xx979xx/neo/giraffe/fca/README.md

FCA (Fiat Chrysler Automotive) Giraffe
====

Get your panda deeper into your:

- 2017 Chrysler Pacifica Hybrid

May fit other FCA cars as well.

The switches
====

The 2 DIP switches control signals to the stock ADAS system

- 1 -- IGN to camera

- 2 -- ADAS CAN1 -> camera CAN (OBDII pins 12 & 13)

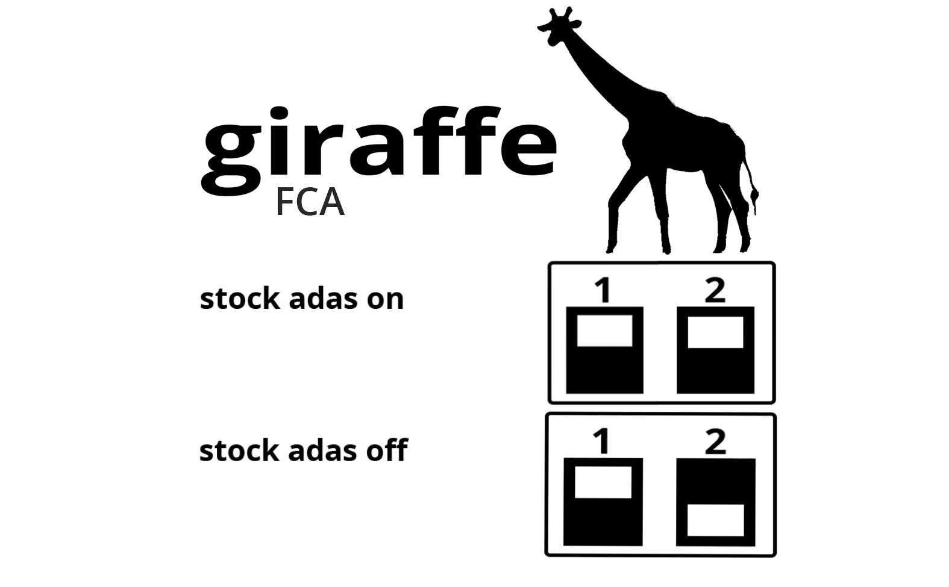
[picture p1: giraffe/fca/fca_switches.png]


Initial design from the community from: [@adhintz](https://github.com/adhintz)
