xx979xx/neo/giraffe/toyota/README.md

Toyota giraffe
====

Get your panda deeper into your compatible Toyota vehicle

The switches
====

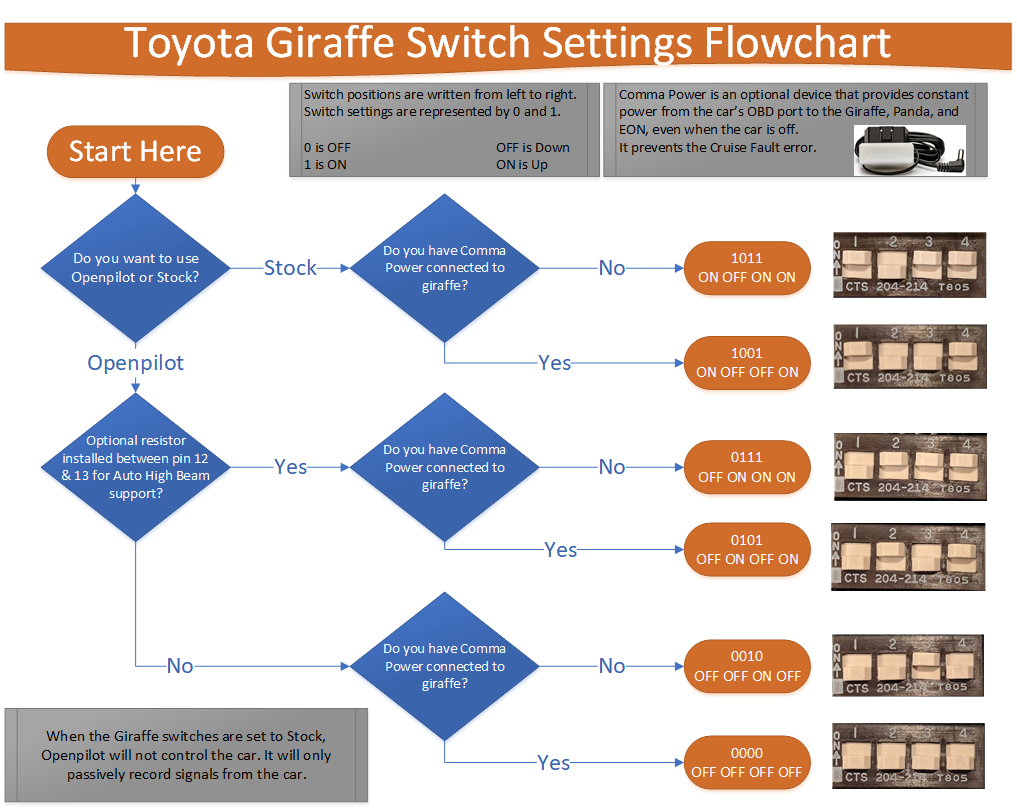
[picture p2: giraffe/toyota/toyota_giraffe_switch_flowchart.png]
