xx979xx/neo/giraffe/honda/bosch/README.md

Honda giraffe (Bosch ADAS)
====

Get your panda deeper into your:

- 2017+ Honda CR-V
- 2017+ Honda Civic Hatchback
- 2018+ Honda Accord

May fit other Hondas with Bosch hardware as well.

The switches
====

The 2 DIP switches control signals to the stock ADAS system

- 1 -- IGN to camera

- 2 -- ADAS CAN2 -> camera CAN (OBDII pins 12 & 13)

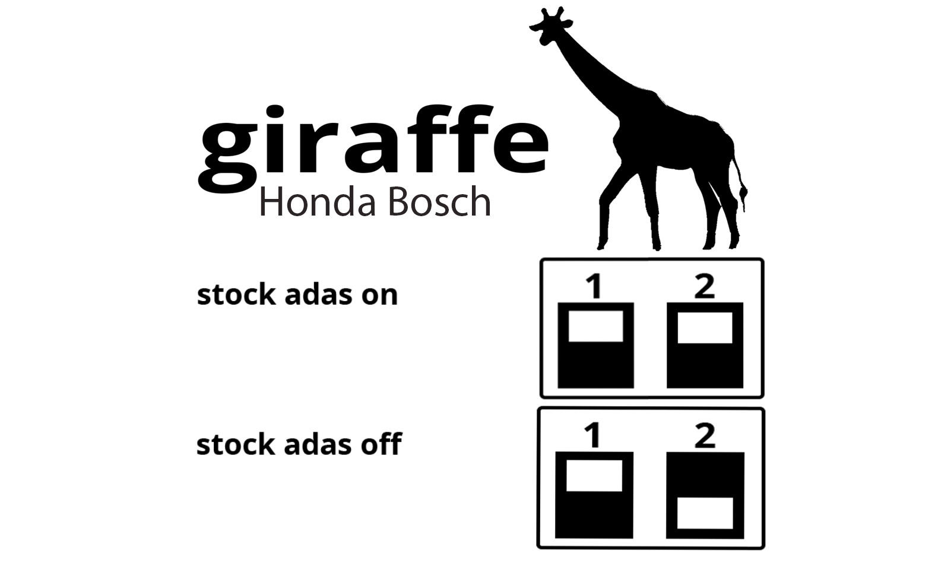
[picture p3: giraffe/honda/bosch/bosch_switches.png]


Initial design from the community from: [@csouers](https://github.com/csouers), [@energee](https://github.com/energee), and Alaric Egli
