xx979xx/neo/giraffe/honda/nidec_inverted/README.md

Honda Inverted Giraffe
====

Get your panda deeper into your Odyssey, 2019 Honda Pilot, TLX and probably other cars with an "inverted" connector

The switches
====

The 4 DIP switches control signals to the stock ADAS system

- 1 -- ADAS CAN1 -> main body CAN

- 2 -- ADAS CAN1 -> panda CAN3 (OBDII pins 12 & 13)

- 3 -- ADAS CAN2 -> radar CAN

- 4 -- ADAS power & ignition -> power & ignition

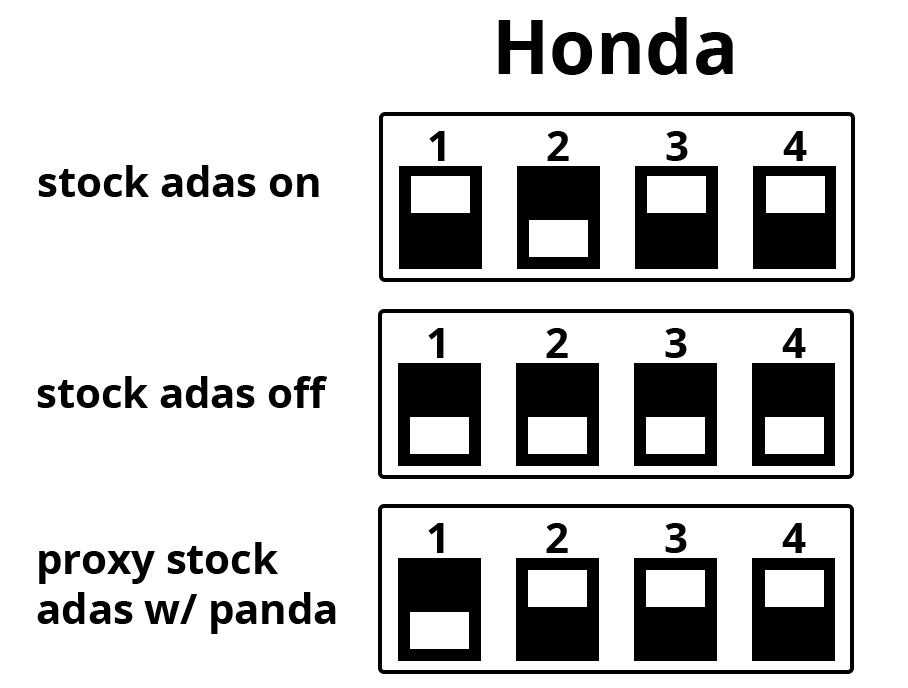
[picture p4: giraffe/honda/nidec_inverted/nidec_switches.png]


Thanks to [@csouers](https://github.com/csouers) and [@energee](https://github.com/energee) for their input on this design
