xx979xx/neo/interface boards/gm/resources/1) front.jpg

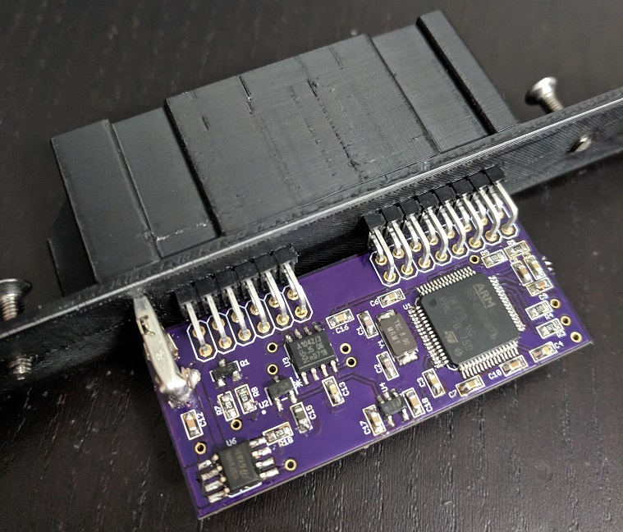
interface boards/gm/resources/1) front.jpg
