xx979xx/neo/interface boards/gm/resources/2) power pins.jpg

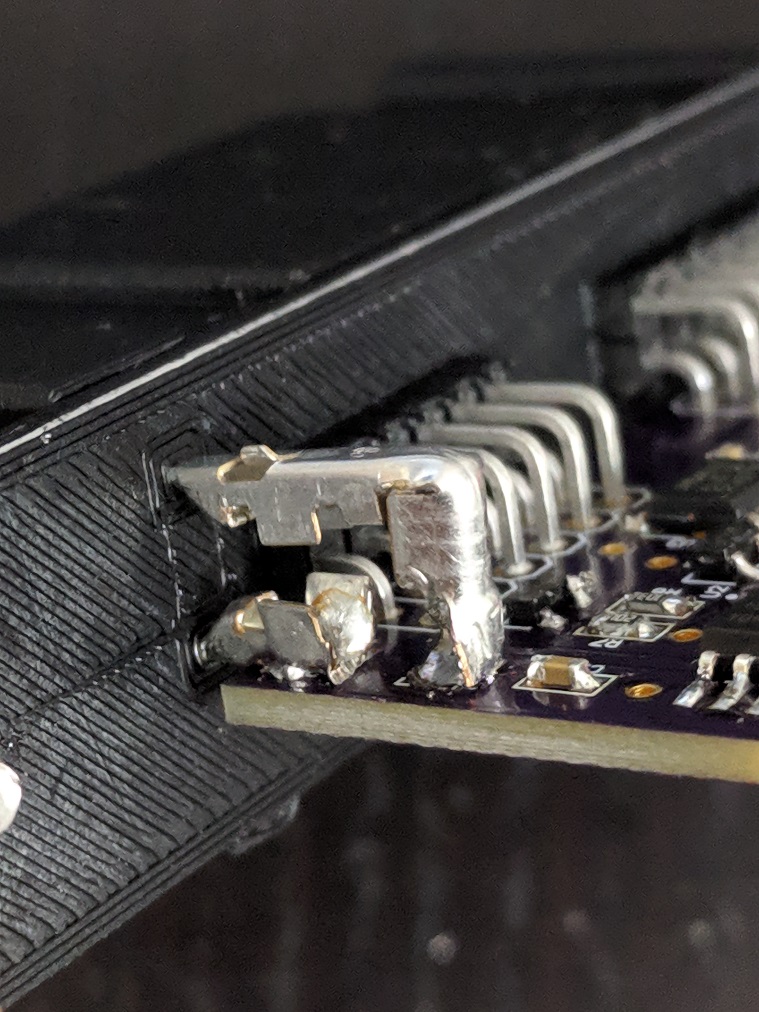
interface boards/gm/resources/2) power pins.jpg
