xx979xx/neo/interface boards/gm/resources/3) back.jpg

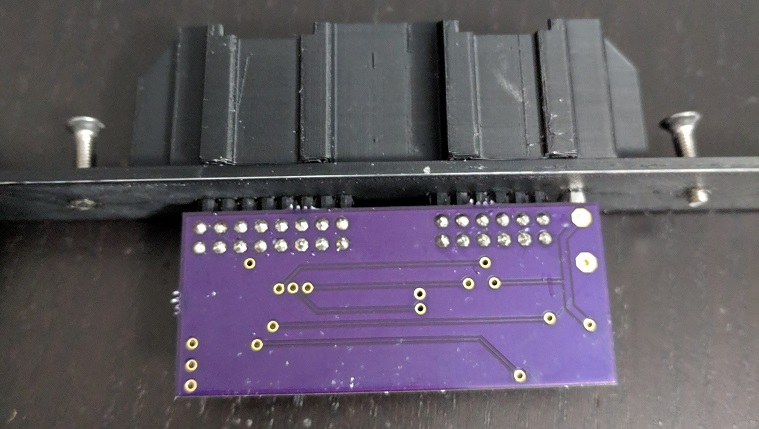
interface boards/gm/resources/3) back.jpg
