xx979xx/neo/interface boards/gm/resources/4) pin immobilizer.jpg

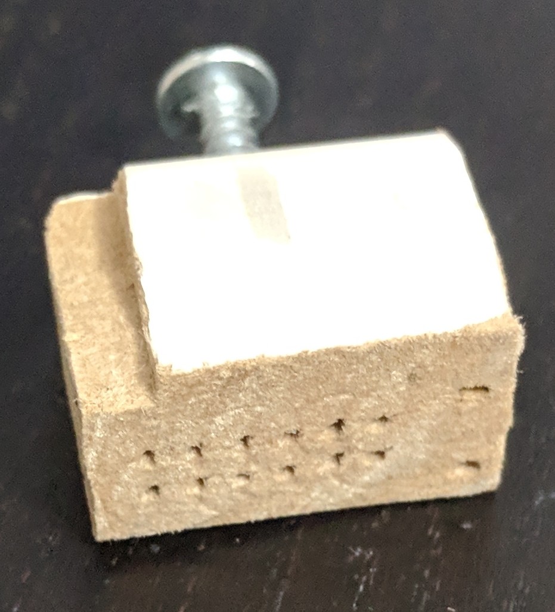
interface boards/gm/resources/4) pin immobilizer.jpg
