xx979xx/neo/giraffe/hyundai/BOM.csv

Ref Des | Package | Manufacturer PN | Qty | Link
U1 | 12-Pin | MG645845 | 1 | https://chcwld.en.alibaba.com/product/60784996669-801836231/KET_020_12M_Automotive_cable_connector_Electronic_Connector.html
U2 | 12-Pin | MG655794 | 1 | https://chcwld.en.alibaba.com/product/60784830234-801836231/KET_020_12F_Automotive_cable_connector_Electronic_Connector.html
 |  | ST731407-3 | 12
J1 | 16-pin | OBDII-FEMALE | 1 | https://cn1514770021qfbj.en.alibaba.com/product/60598699808-804284542/J1962F_OBD2_16_Pin_Female_connector_OBD2_Socket.html
J2 | RJ45-RA | A-2004-2-4-LPS-N-R | 1 | https://www.digikey.com/product-detail/en/assmann-wsw-components/A-2004-2-4-LPS-N-R/AE10387-ND/2183638
J3 | 3-pin | EJ508A | 1 | https://www.digikey.com/products/en?keywords=ej508a
SW1 | SMD | 204-214ST | 1 | https://www.digikey.com/scripts/DkSearch/dksus.dll?Detail&itemSeq=238874105&uq=636415194298612120
R1 | 0603-R | ERJ-PA3J121V | 1 | https://www.digikey.com/product-detail/en/panasonic-electronic-components/ERJ-PA3J121V/P120BZCT-ND/5036246
