xx979xx/neo/giraffe/fca/Giraffe_left.stl

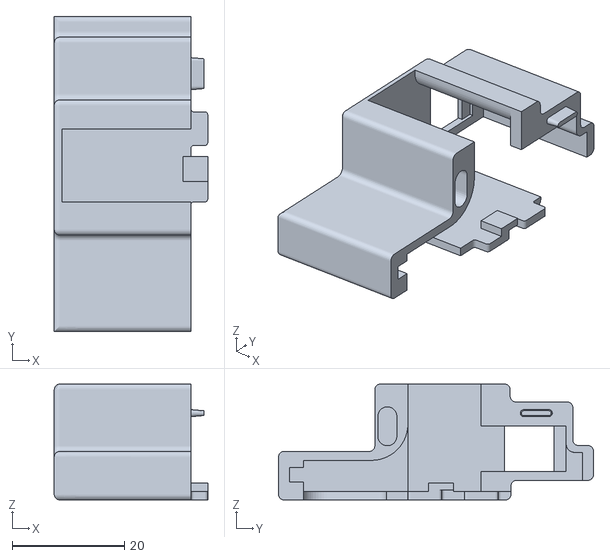
[picture p9: CAD file, 2019-06-29]
giraffe/fca/Giraffe_left.stl
27.4 x 56.2 x 20.7
