xx979xx/neo/giraffe/ford/mechanical/giraffe_ford_spacer.stl

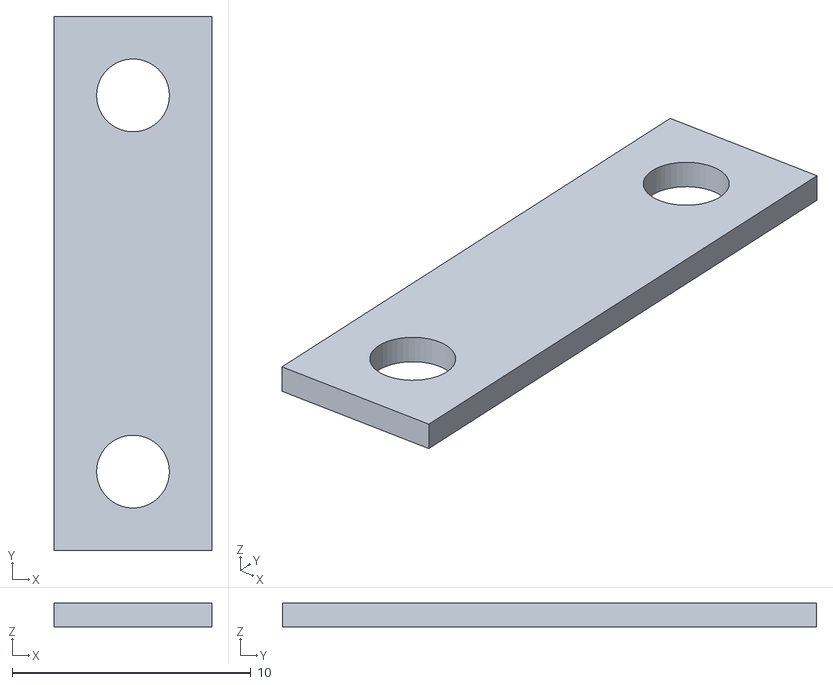
[picture p10: CAD file, 2019-06-29]
giraffe/ford/mechanical/giraffe_ford_spacer.stl
6.60 x 22.4 x 1.00
