xx979xx/neo/giraffe/honda/bosch/bosch_female_connector.stl

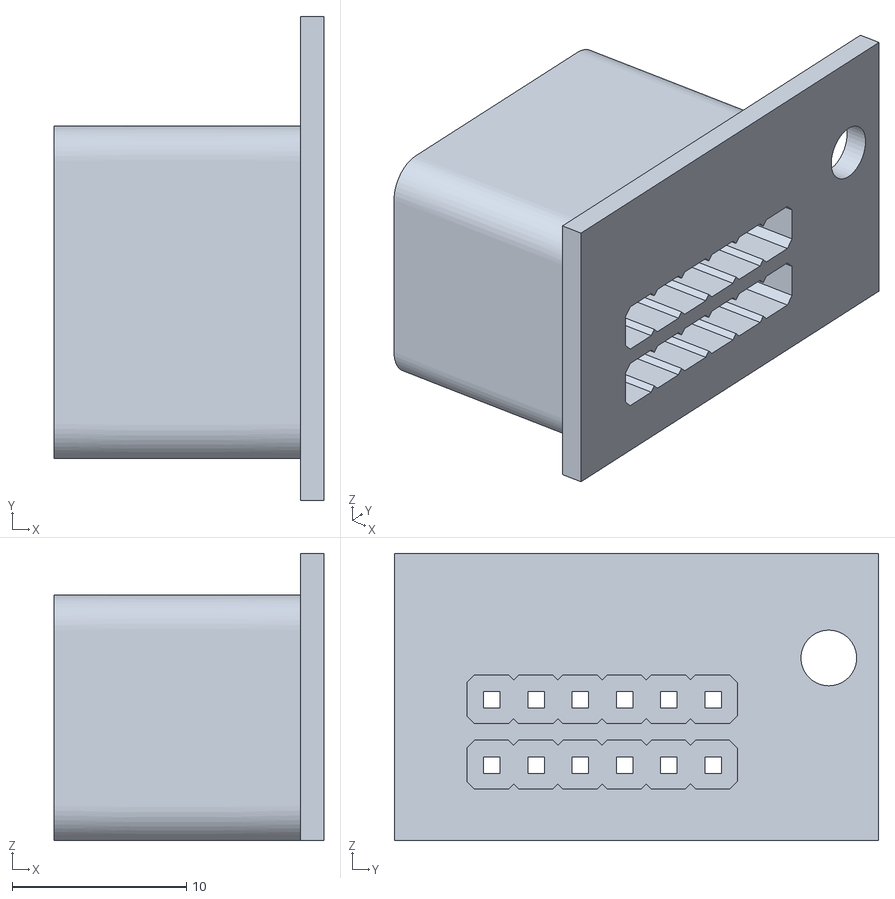
[picture p11: CAD file, 2019-06-29]
giraffe/honda/bosch/bosch_female_connector.stl
15.5 x 27.8 x 16.5
