xx979xx/neo/giraffe/honda/nidec_inverted/case.stl

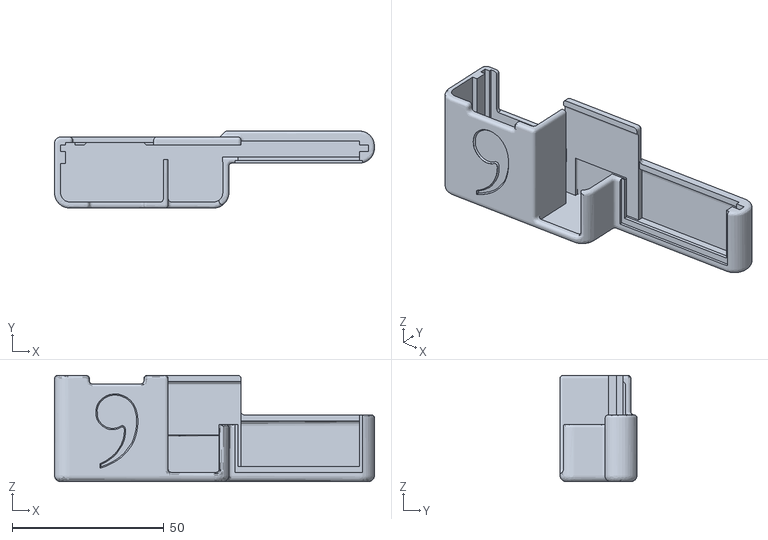
[picture p12: CAD file, 2019-06-29]
giraffe/honda/nidec_inverted/case.stl
105.5 x 25.4 x 35.0
