xx979xx/neo/giraffe/hyundai/Hyundai_Giraffe.stl

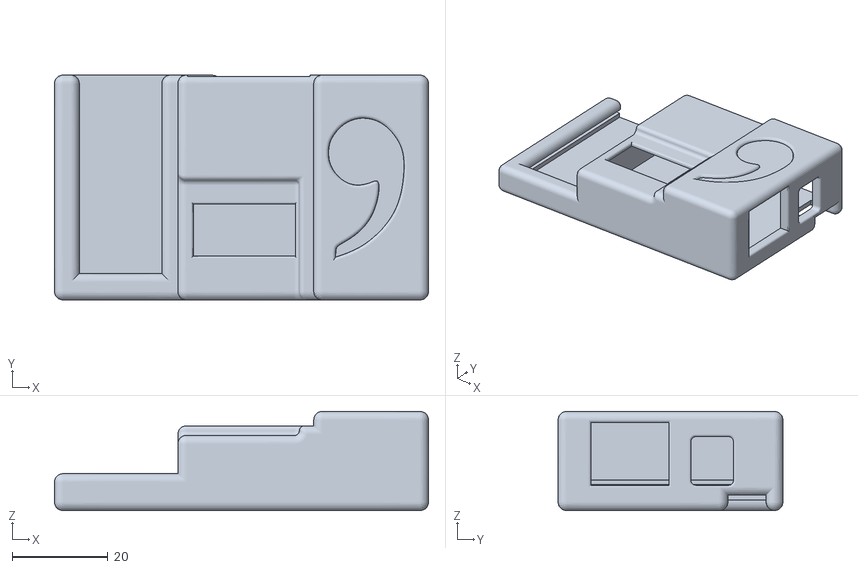
[picture p13: CAD file, 2019-06-29]
giraffe/hyundai/Hyundai_Giraffe.stl
78.2 x 47.0 x 20.7
