xx979xx/neo/giraffe/subaru/PIP_right.stl

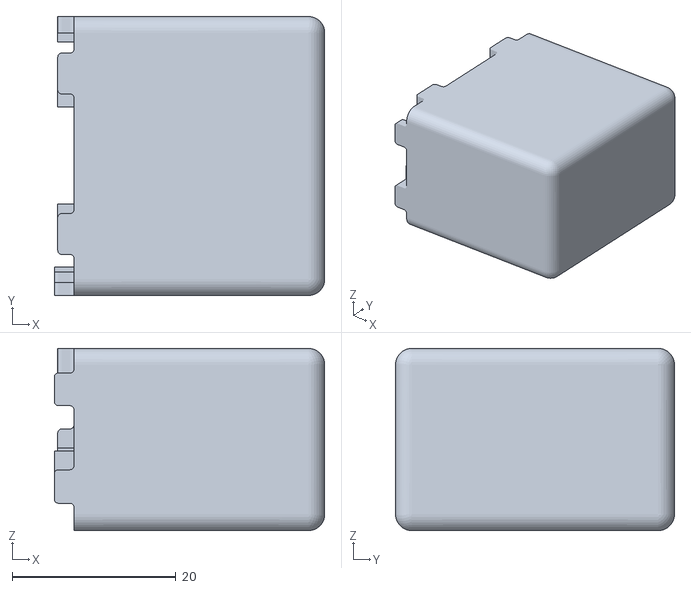
[picture p14: CAD file, 2019-06-29]
giraffe/subaru/PIP_right.stl
33.1 x 34.1 x 22.3
