xx979xx/neo/grey/antenna_mount_28deg.stl

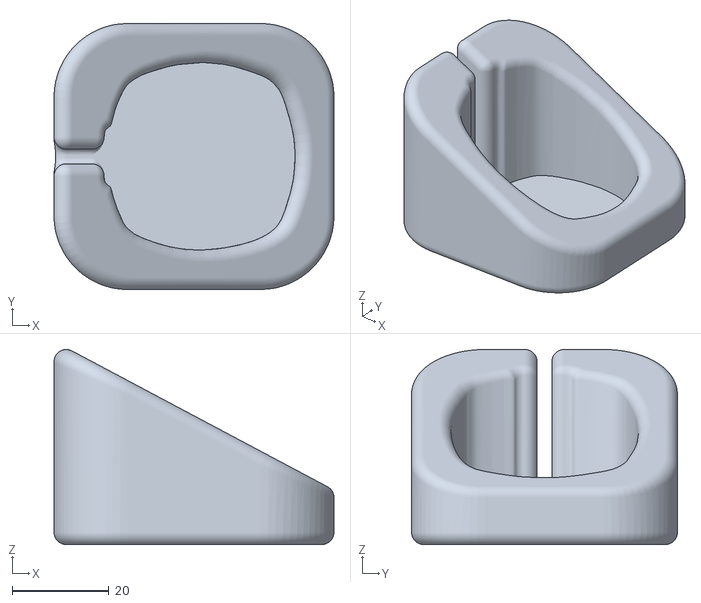
[picture p15: CAD file, 2019-06-29]
grey/antenna_mount_28deg.stl
58.0 x 55.1 x 40.4
