xx979xx/neo/interface boards/gm/case.stl

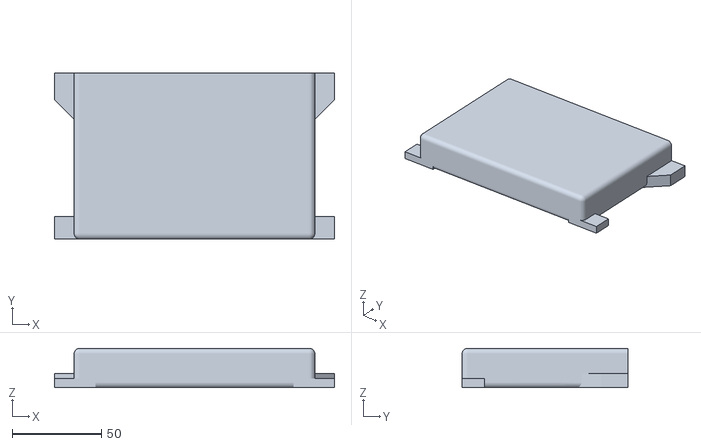
[picture p16: CAD file, 2019-06-29]
interface boards/gm/case.stl
157.0 x 93.0 x 22.0
