xx979xx/neo/giraffe/fca/Giraffe_right.stl

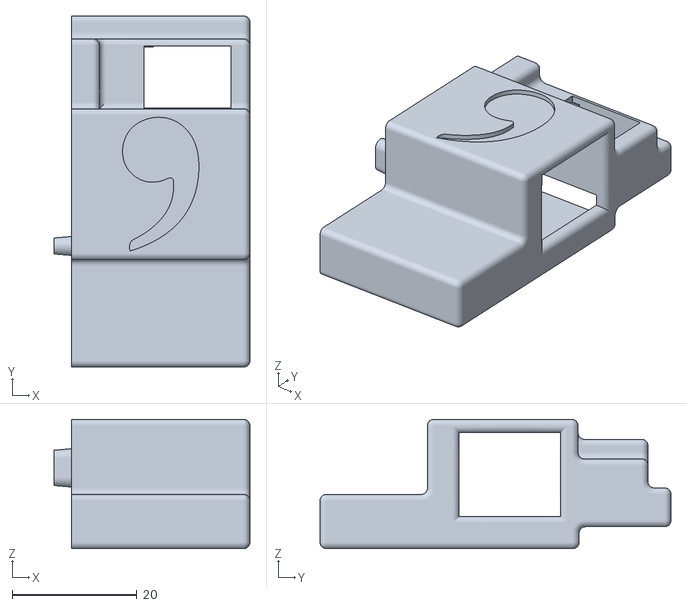
[picture p17: CAD file, 2019-06-29]
giraffe/fca/Giraffe_right.stl
31.4 x 56.2 x 20.7
