xx979xx/neo/giraffe/ford/mechanical/giraffe_ford_top.stl

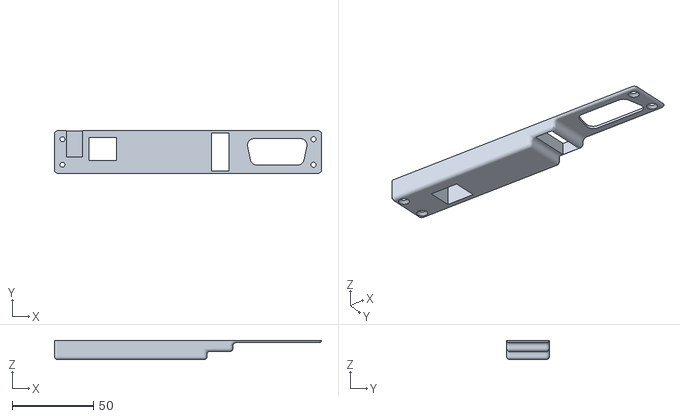
[picture p18: CAD file, 2019-06-29]
giraffe/ford/mechanical/giraffe_ford_top.stl
164.5 x 26.4 x 11.9
