xx979xx/neo/giraffe/honda/bosch/bosch_male.stl

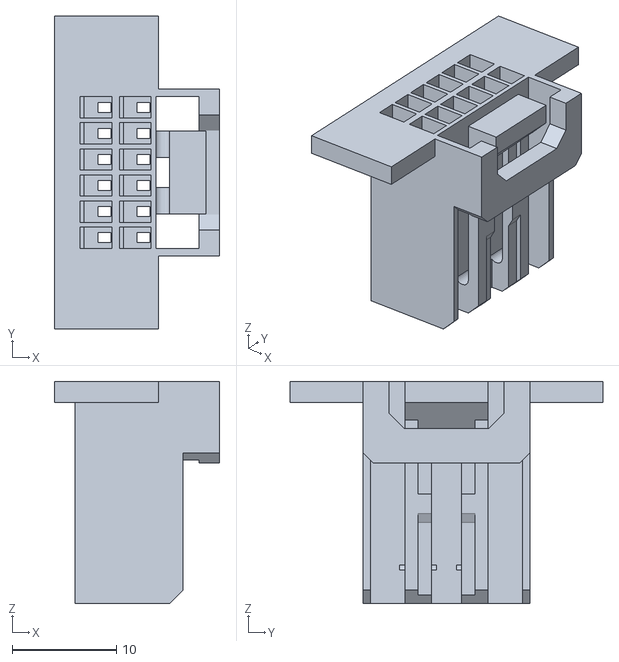
[picture p19: CAD file, 2019-06-29]
giraffe/honda/bosch/bosch_male.stl
15.9 x 30.0 x 21.3
