xx979xx/neo/giraffe/subaru/PIP_left.stl

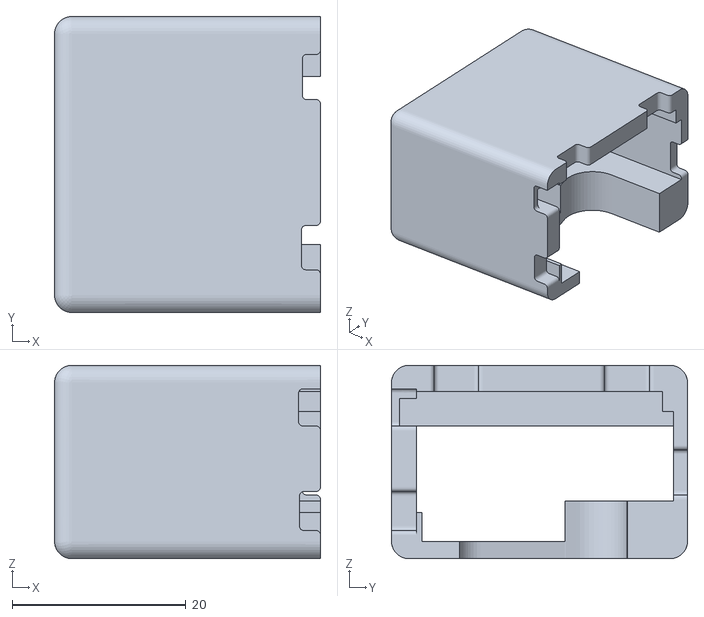
[picture p20: CAD file, 2019-06-29]
giraffe/subaru/PIP_left.stl
30.6 x 34.1 x 22.3
