xx979xx/neo/interface boards/gm/connectors.stl

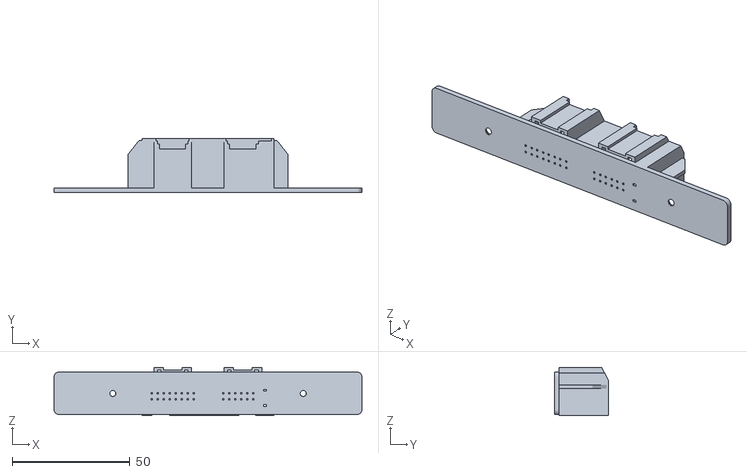
[picture p21: CAD file, 2019-06-29]
interface boards/gm/connectors.stl
131.0 x 23.0 x 20.5
