xx979xx/neo/giraffe/ford/mechanical/giraffe_ford_bottom.stl

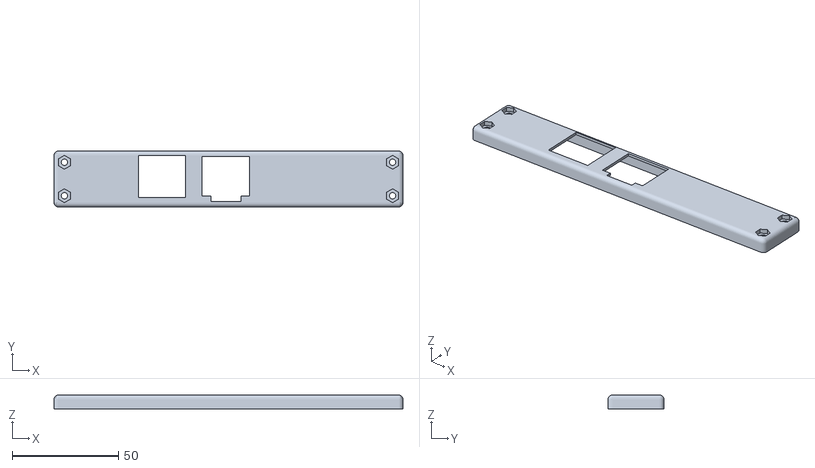
[picture p22: CAD file, 2019-06-29]
giraffe/ford/mechanical/giraffe_ford_bottom.stl
164.5 x 26.4 x 6.57
