xx979xx/neo/giraffe/honda/bosch/bosch_back.stl

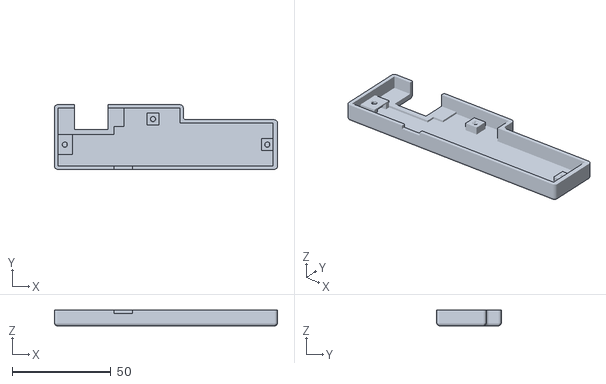
[picture p23: CAD file, 2019-06-29]
giraffe/honda/bosch/bosch_back.stl
113.0 x 32.7 x 8.00
