xx979xx/neo/giraffe/honda/bosch/bosch_front.stl

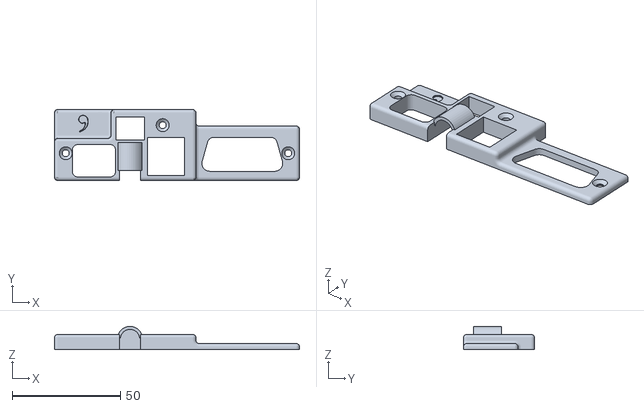
[picture p24: CAD file, 2019-06-29]
giraffe/honda/bosch/bosch_front.stl
113.0 x 32.7 x 10.7
