xx979xx/neo/paw/paw.brd

## EAGLE design paw/paw.brd (2019-06-29)

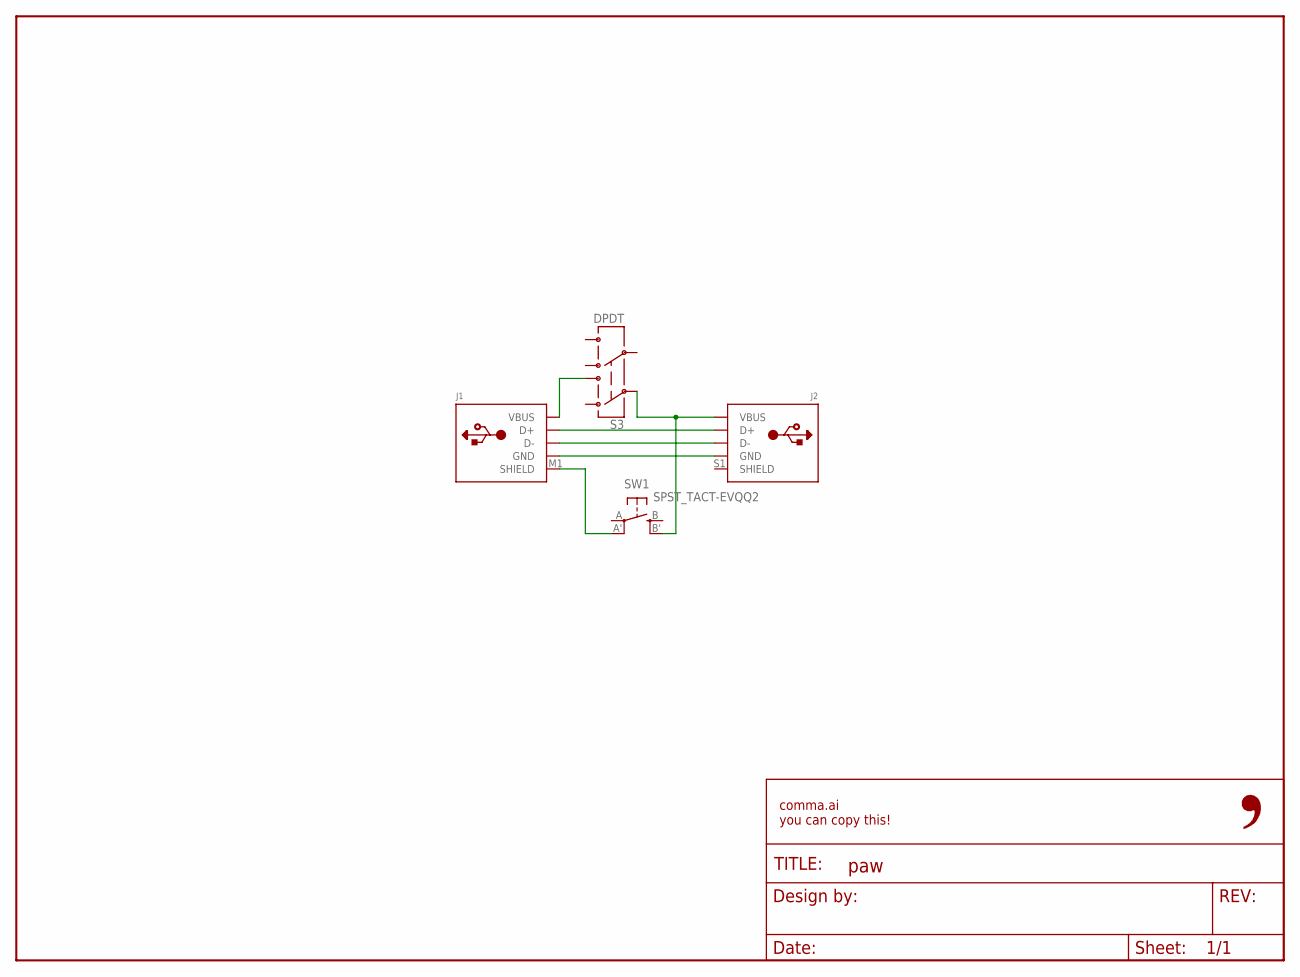
[picture p25: schematic paw.sch]

Parts:
FRAME1: FRAME-LETTER-OPENNO_PACKAGE; DUMMY
J1: USB-AA-M; MOLEX_480371000
J2: USB-MINIBSMD; USB-MINIB
S3: DPDT; AYZ0202
SW1: SPST_TACT-EVQQ2; EVQ-Q2

Connections:
unnamed: J1.3 (D+), J2.D+
unnamed: J1.2 (D-), J2.D-
unnamed: J1.4 (GND), J2.GND
unnamed: J1.M1 (SHIELD), SW1.A' (P1)
unnamed: J1.1 (VBUS), S3.3
unnamed: J2.VBUS, S3.2, SW1.B' (S1)

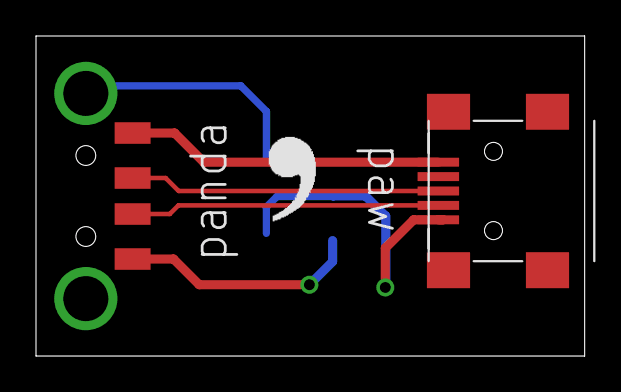
[picture p26: board paw.brd from above]

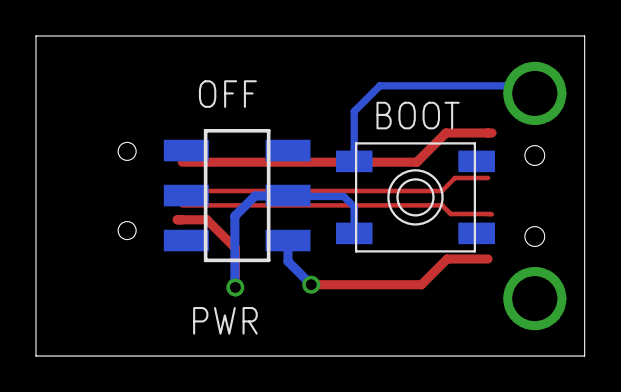
[picture p27: board paw.brd from below]

Board: 2 copper layers, 30.5 x 17.8 mm, 6 parts (2 on the bottom side), 6 nets.

Other parts of the board:
U$1: LOGO
