xx979xx/neo/giraffe/fca/fca_giraffe.brd

## EAGLE design giraffe/fca/fca_giraffe.brd (2019-06-29)

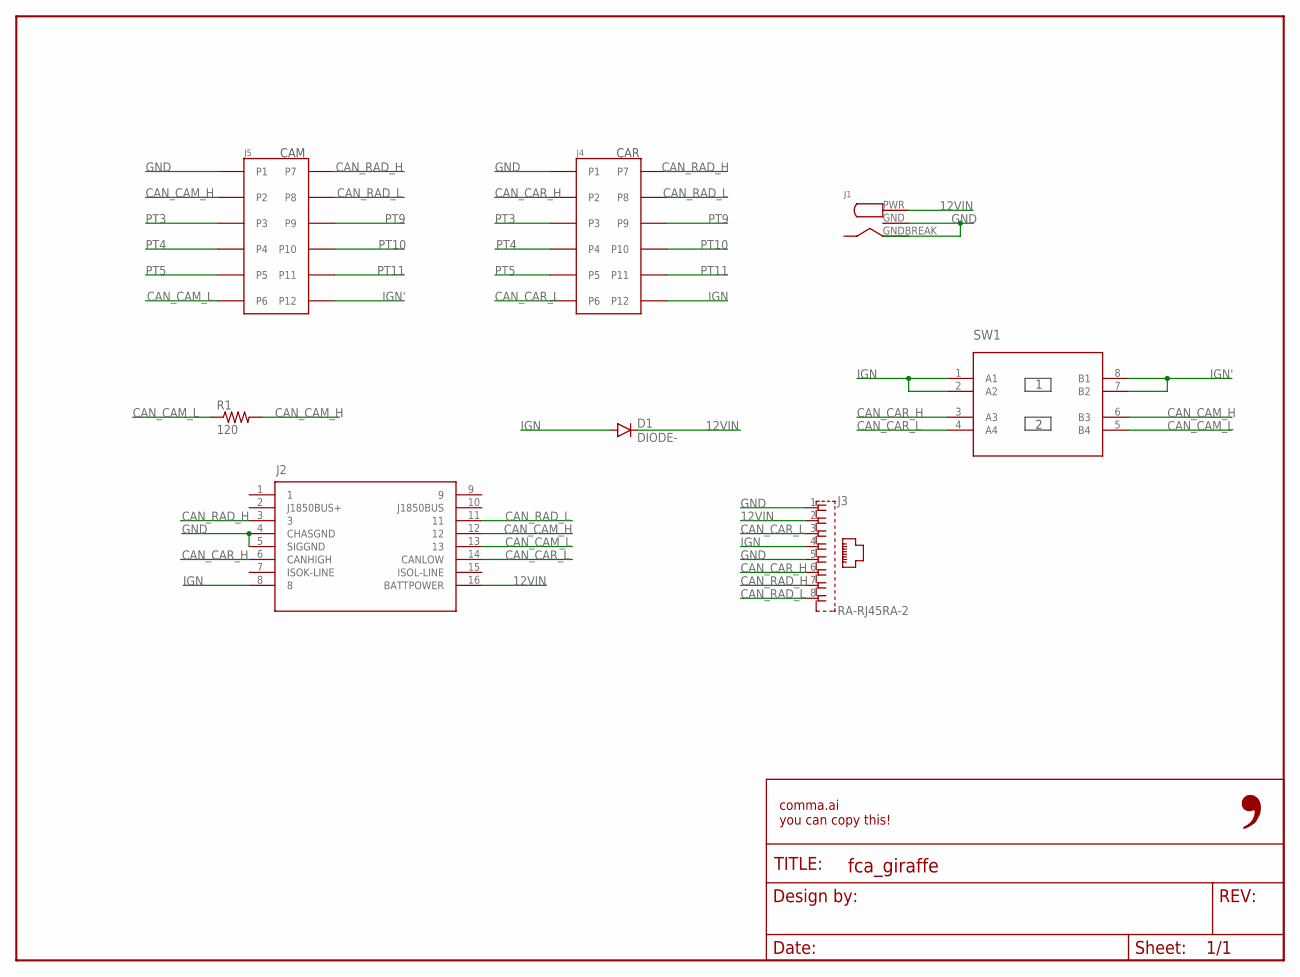
[picture p30: schematic fca_giraffe.sch]

Parts:
D1: DIODE-; DO-214
FRAME1: FRAME-LETTER-OPENNO_PACKAGE; DUMMY
J1: RASM722PX
J2: OBDII-FEMALE-CUT; OBDII-FEMALE-MIDCUT
J3: RA-RJ45RA-2; RA-RJ45-2
J4: 0348250124
J5: 0348240124
R1: 120; 0603-R
SW1: 2XDPST-CTS; 2-DPST

Connections:
12VIN: D1.1 (C), J1.PWR (12VIN), J2.16 (BATTPOWER), J3.2
CAN_CAM_H: J2.12, J5.P2, R1.2, SW1.6 (B3)
CAN_CAM_L: J2.13, J5.P6, R1.1, SW1.5 (B4)
CAN_CAR_H: J2.6 (CANHIGH), J3.6, J4.P2, SW1.3 (A3)
CAN_CAR_L: J2.14 (CANLOW), J3.3, J4.P6, SW1.4 (A4)
CAN_RAD_H: J2.3, J3.7, J4.P7, J5.P7
CAN_RAD_L: J2.11, J3.8, J4.P8, J5.P8
GND: J1.GND, J1.GNDBREAK, J2.4 (CHASGND), J2.5 (SIGGND), J3.1, J3.5, J4.P1, J5.P1
IGN: D1.2 (A), J2.8, J3.4, J4.P12, SW1.1 (A1), SW1.2 (A2)
IGN': J5.P12, SW1.7 (B2), SW1.8 (B1)
PT3: J4.P3, J5.P3
PT4: J4.P4, J5.P4
PT5: J4.P5, J5.P5
PT9: J4.P9, J5.P9
PT10: J4.P10, J5.P10
PT11: J4.P11, J5.P11

Notes on the sheet:
CAR
CAM

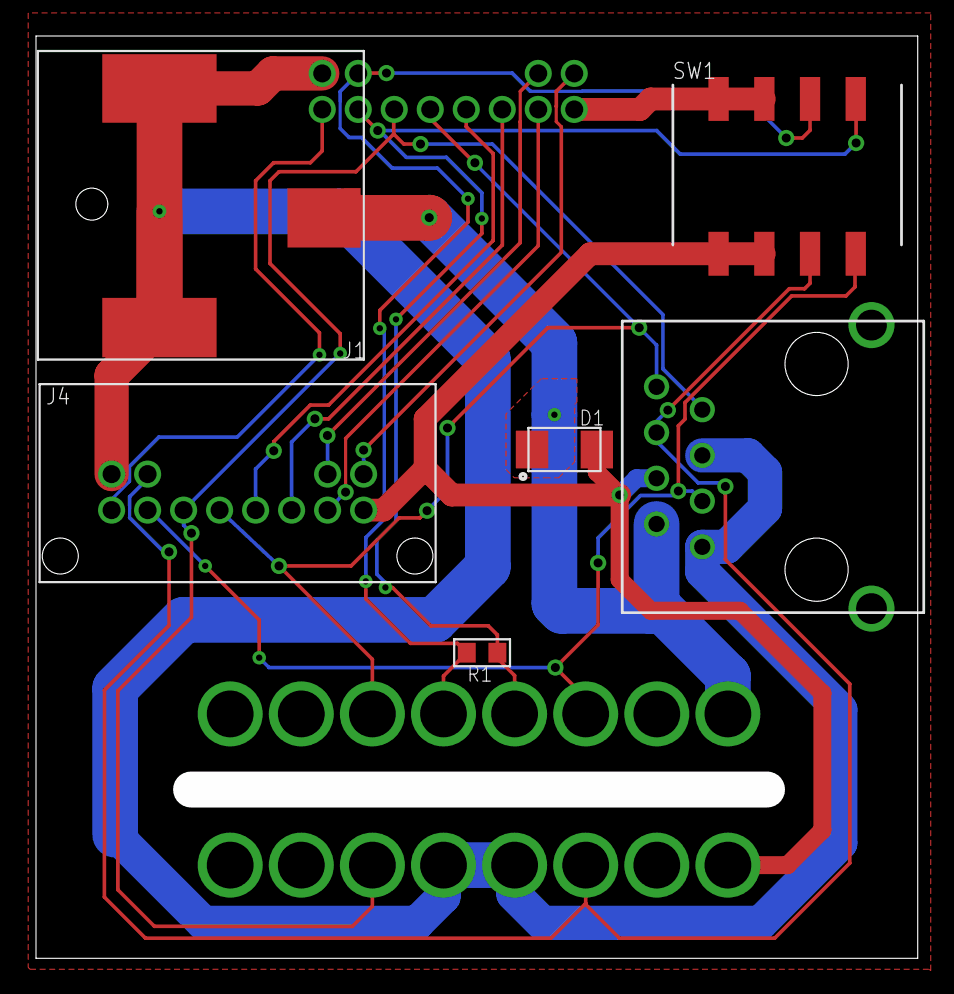
[picture p31: board fca_giraffe.brd from above]

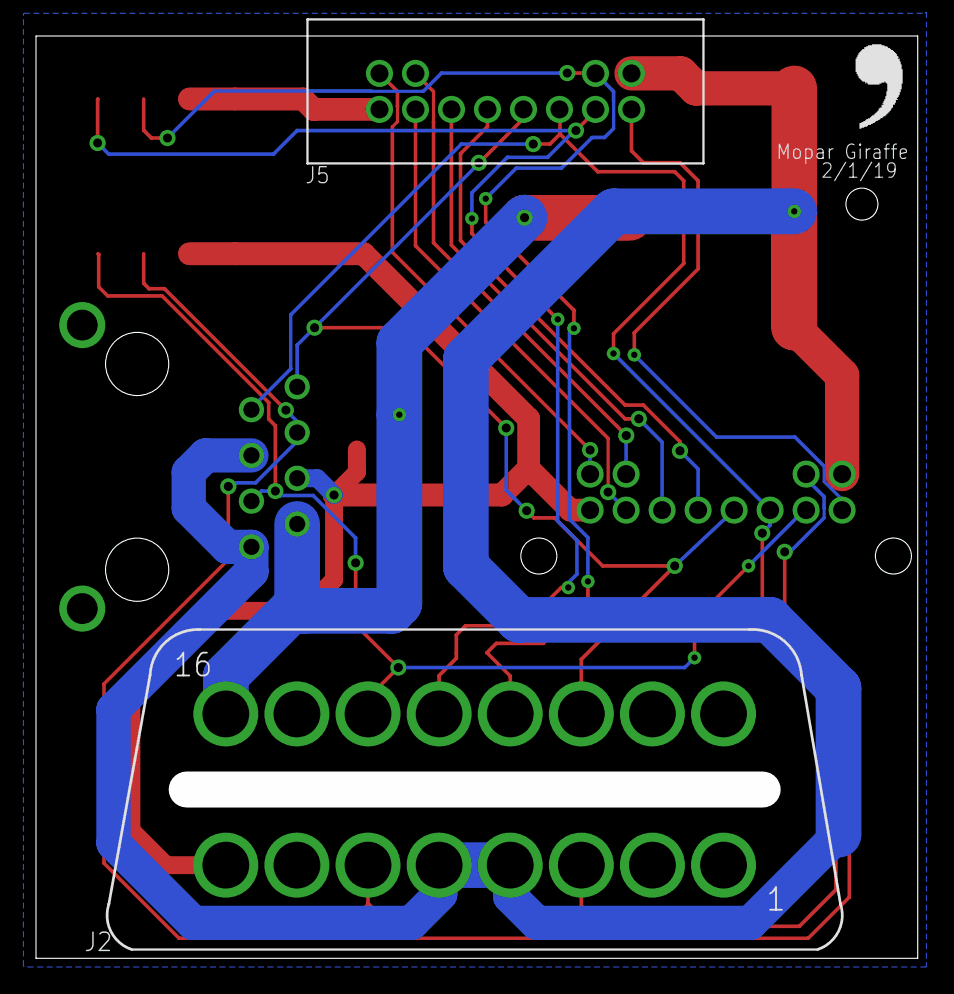
[picture p32: board fca_giraffe.brd from below]

Board: 2 copper layers, 49.0 x 51.2 mm, 10 parts (3 on the bottom side), 16 nets.

Other parts of the board:
U$1: LOGO
