xx979xx/neo/giraffe/toyota/giraffe12.brd

## EAGLE design giraffe/toyota/giraffe12.brd (2019-06-29)

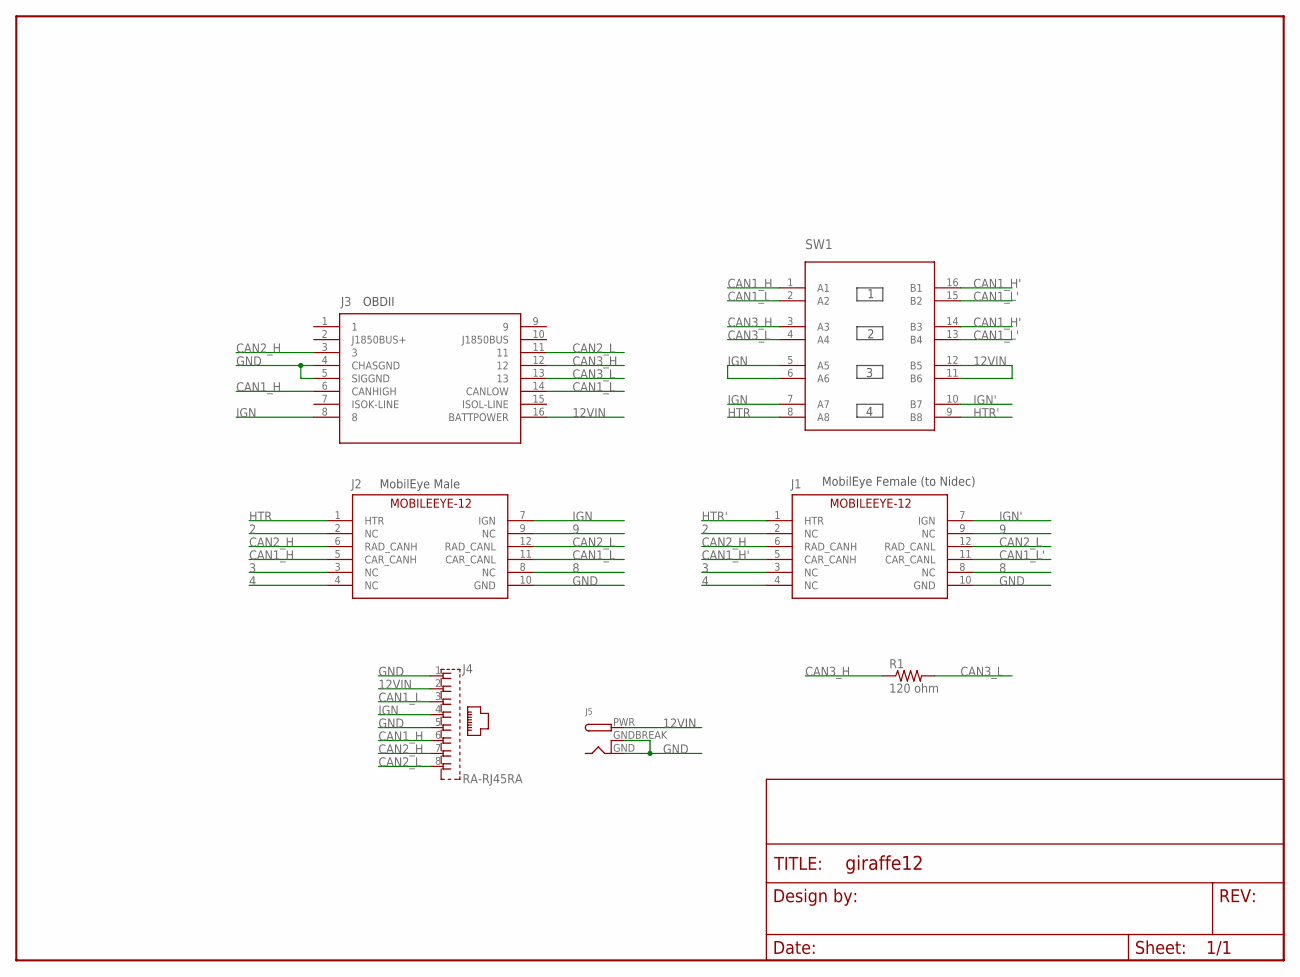
[picture p33: schematic giraffe12.sch]

Parts:
FRAME1: FRAME-LETTERNO_PACKAGE; DUMMY
J1: MOBILEEYE-12FEMALE; 2X6-TE-FEMALE
J2: MOBILEEYE-12MALE; 2X6-TE-RA
J3: OBDII-FEMALE-CUT; OBDII-FEMALE-MIDCUT
J4: RA-RJ45RA; RA-RJ45
J5: DCBARRELPTH; DCJACK_2MM_PTH
R1: 120 ohm; 0603-R
SW1: 4XDPSTSMT; 4-DPST

Connections:
2: J1.2 (NC), J2.2 (NC)
3: J1.3 (NC), J2.3 (NC)
4: J1.4 (NC), J2.4 (NC)
8: J1.8 (NC), J2.8 (NC)
9: J1.9 (NC), J2.9 (NC)
12VIN: J3.16 (BATTPOWER), J4.2, J5.PWR, SW1.11 (B6), SW1.12 (B5)
CAN1_H: J2.5 (CAR_CANH), J3.6 (CANHIGH), J4.6, SW1.1 (A1)
CAN1_H': J1.5 (CAR_CANH), SW1.14 (B3), SW1.16 (B1)
CAN1_L: J2.11 (CAR_CANL), J3.14 (CANLOW), J4.3, SW1.2 (A2)
CAN1_L': J1.11 (CAR_CANL), SW1.13 (B4), SW1.15 (B2)
CAN2_H: J1.6 (RAD_CANH), J2.6 (RAD_CANH), J3.3, J4.7
CAN2_L: J1.12 (RAD_CANL), J2.12 (RAD_CANL), J3.11, J4.8
CAN3_H: J3.12, R1.1, SW1.3 (A3)
CAN3_L: J3.13, R1.2, SW1.4 (A4)
GND: J1.10 (GND), J2.10 (GND), J3.4 (CHASGND), J3.5 (SIGGND), J4.1, J4.5, J5.GND, J5.GNDBREAK
HTR: J2.1 (HTR), SW1.8 (A8)
HTR': J1.1 (HTR), SW1.9 (B8)
IGN: J2.7 (IGN), J3.8, J4.4, SW1.5 (A5), SW1.6 (A6), SW1.7 (A7)
IGN': J1.7 (IGN), SW1.10 (B7)

Notes on the sheet:
OBDII
MobilEye Male
MobilEye Female (to Nidec)

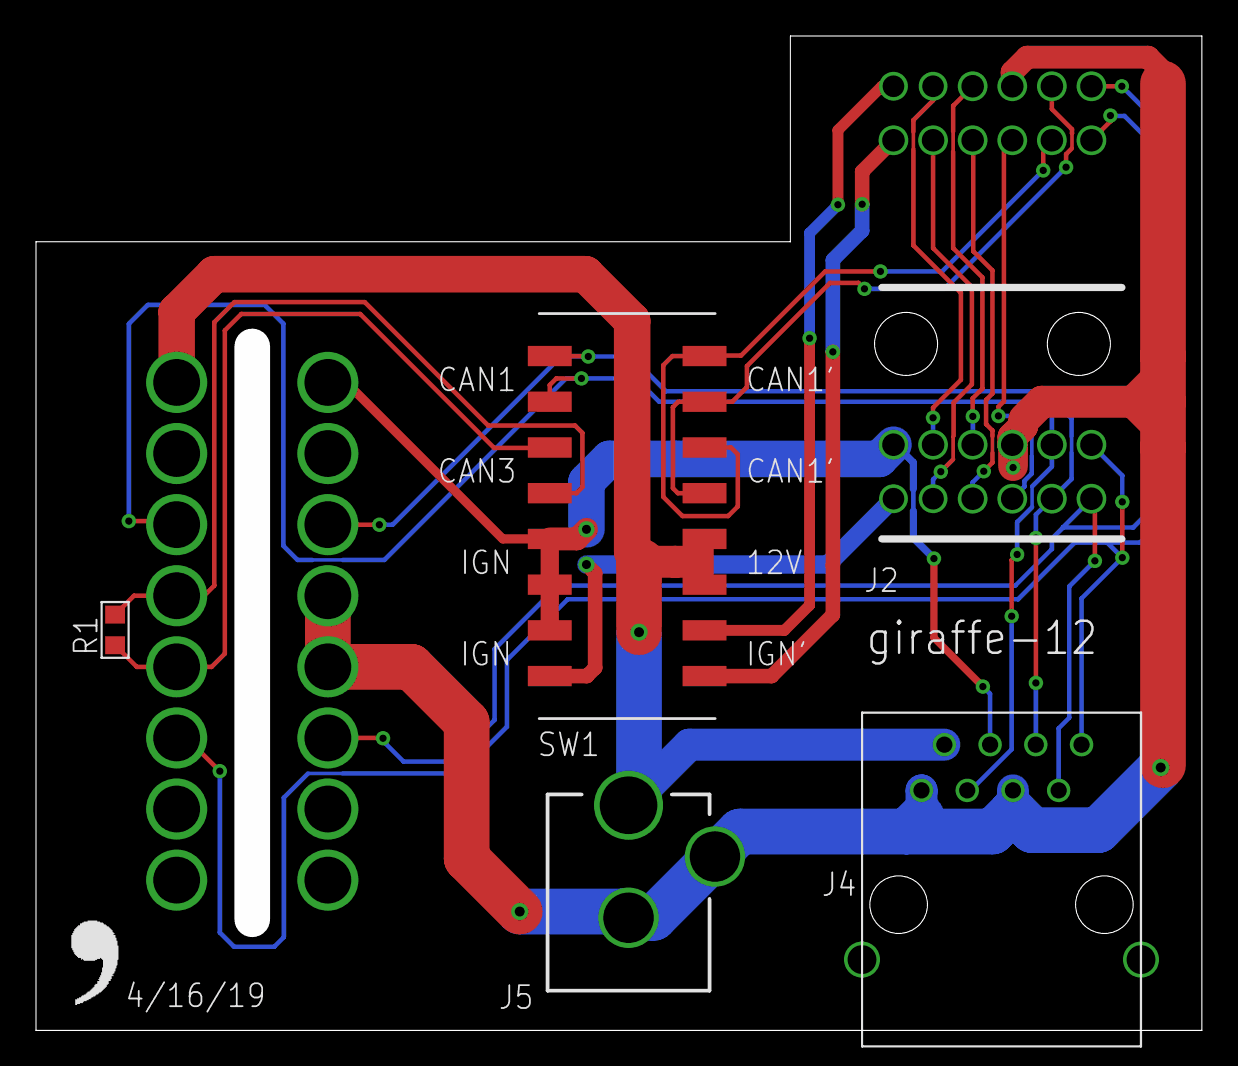
[picture p34: board giraffe12.brd from above]

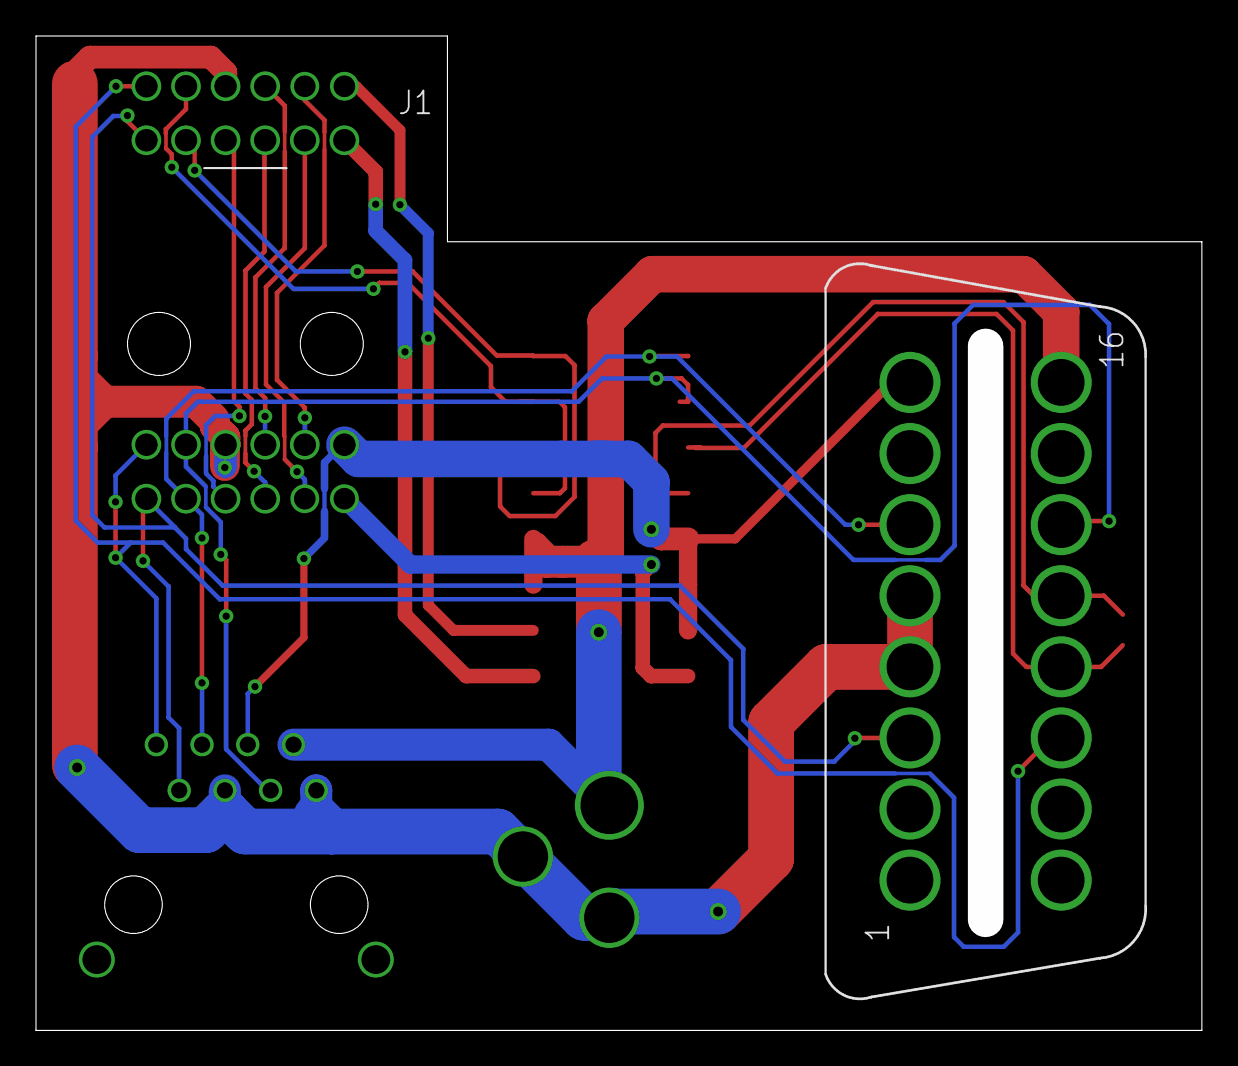
[picture p35: board giraffe12.brd from below]

Board: 2 copper layers, 64.8 x 55.2 mm, 9 parts (2 on the bottom side), 19 nets.

Other parts of the board:
U$1: LOGO
