xx979xx/neo/giraffe/honda/bosch/giraffe_bosch_comma.brd

## EAGLE design giraffe/honda/bosch/giraffe_bosch_comma.brd (2019-06-29)

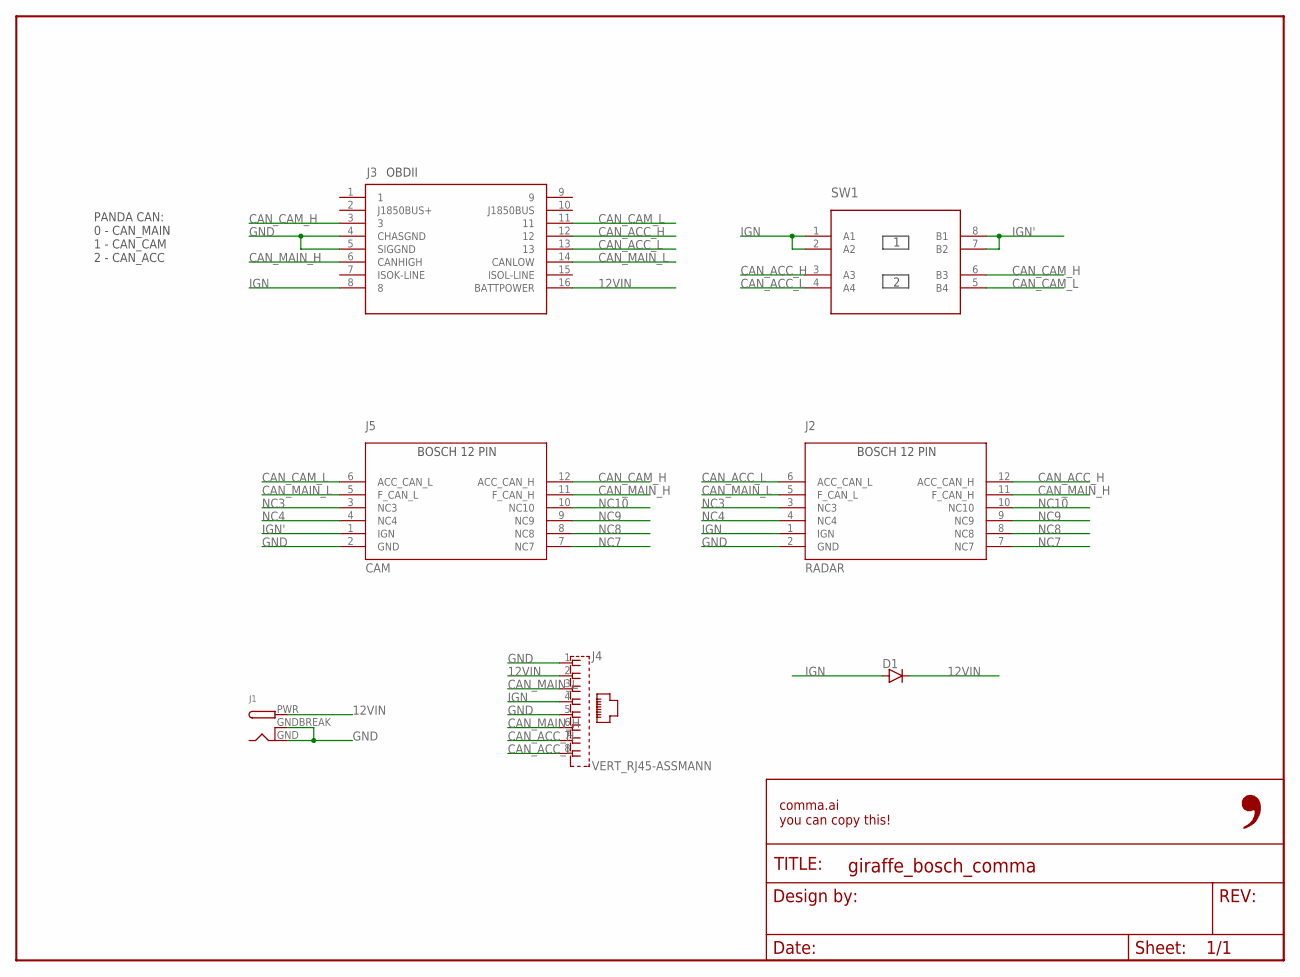
[picture p36: schematic giraffe_bosch_comma.sch]

Parts:
D1: DIODE-; DO-214
FRAME1: FRAME-LETTER-OPENNO_PACKAGE; DUMMY
J1: DCBARRELPTH; DCJACK_2MM_PTH
J2: RADAR; BOSCH_12_PIN_FEMALE
J3: OBDII-FEMALE-CUT; OBDII-FEMALE-MIDCUT
J4: VERT_RJ45-ASSMANN; RJ45-VERT
J5: CAM; BOSCH_12_PIN_MALE
SW1: 2XDPST-CTS; 2-DPST

Connections:
12VIN: D1.1 (C), J1.PWR, J3.16 (BATTPOWER), J4.2
CAN_ACC_H: J2.12 (ACC_CAN_H), J3.12, J4.7, SW1.3 (A3)
CAN_ACC_L: J2.6 (ACC_CAN_L), J3.13, J4.8, SW1.4 (A4)
CAN_CAM_H: J3.3, J5.12 (ACC_CAN_H), SW1.6 (B3)
CAN_CAM_L: J3.11, J5.6 (ACC_CAN_L), SW1.5 (B4)
CAN_MAIN_H: J2.11 (F_CAN_H), J3.6 (CANHIGH), J4.6, J5.11 (F_CAN_H)
CAN_MAIN_L: J2.5 (F_CAN_L), J3.14 (CANLOW), J4.3, J5.5 (F_CAN_L)
GND: J1.GND, J1.GNDBREAK, J2.2 (GND), J3.4 (CHASGND), J3.5 (SIGGND), J4.1, J4.5, J5.2 (GND)
IGN: D1.2 (A), J2.1 (IGN), J3.8, J4.4, SW1.1 (A1), SW1.2 (A2)
IGN': J5.1 (IGN), SW1.7 (B2), SW1.8 (B1)
NC3: J2.3 (NC3), J5.3 (NC3)
NC4: J2.4 (NC4), J5.4 (NC4)
NC7: J2.7 (NC7), J5.7 (NC7)
NC8: J2.8 (NC8), J5.8 (NC8)
NC9: J2.9 (NC9), J5.9 (NC9)
NC10: J2.10 (NC10), J5.10 (NC10)

Notes on the sheet:
OBDII
PANDA CAN: 0 - CAN_MAIN 1 - CAN_CAM 2 - CAN_ACC

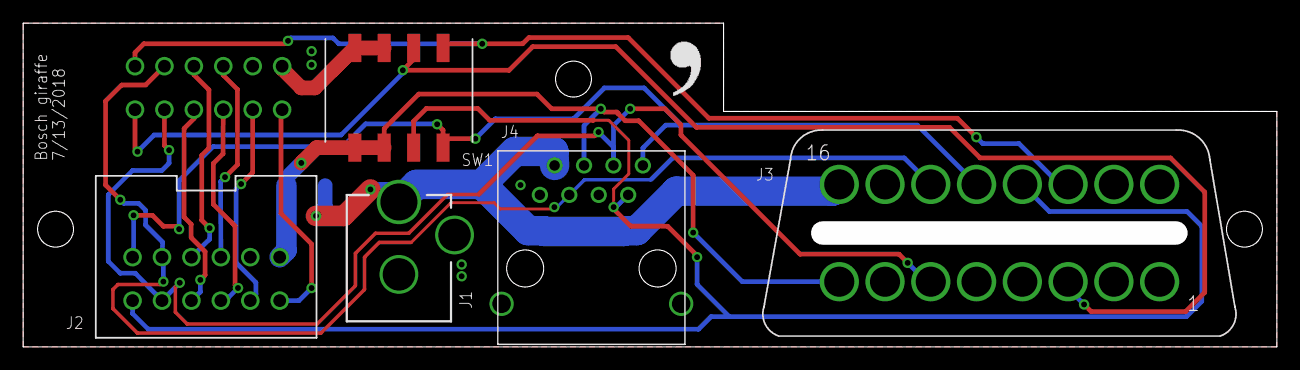
[picture p37: board giraffe_bosch_comma.brd from above]

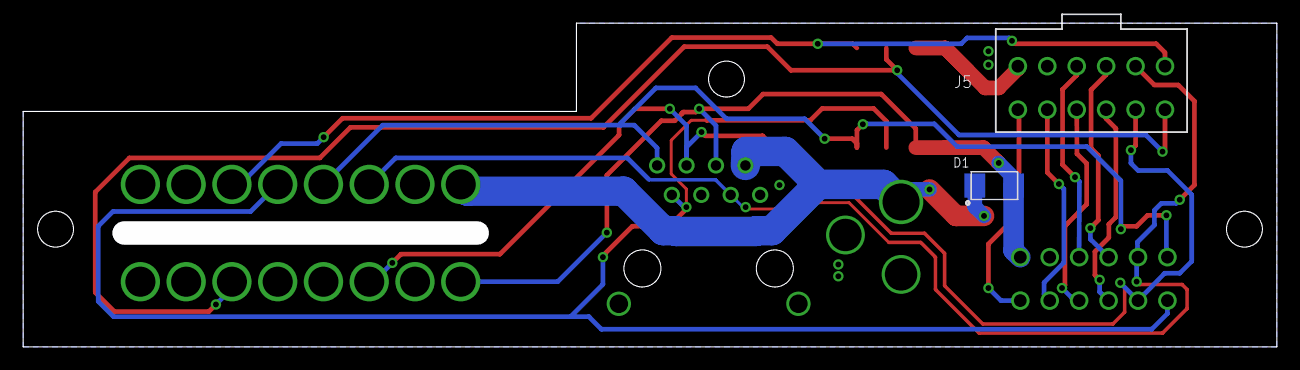
[picture p38: board giraffe_bosch_comma.brd from below]

Board: 2 copper layers, 108.2 x 27.9 mm, 9 parts (2 on the bottom side), 16 nets.

Other parts of the board:
U$1: LOGO
