xx979xx/neo/giraffe/subaru/comma_access_point.brd

## EAGLE design giraffe/subaru/comma_access_point.brd (2019-06-29)

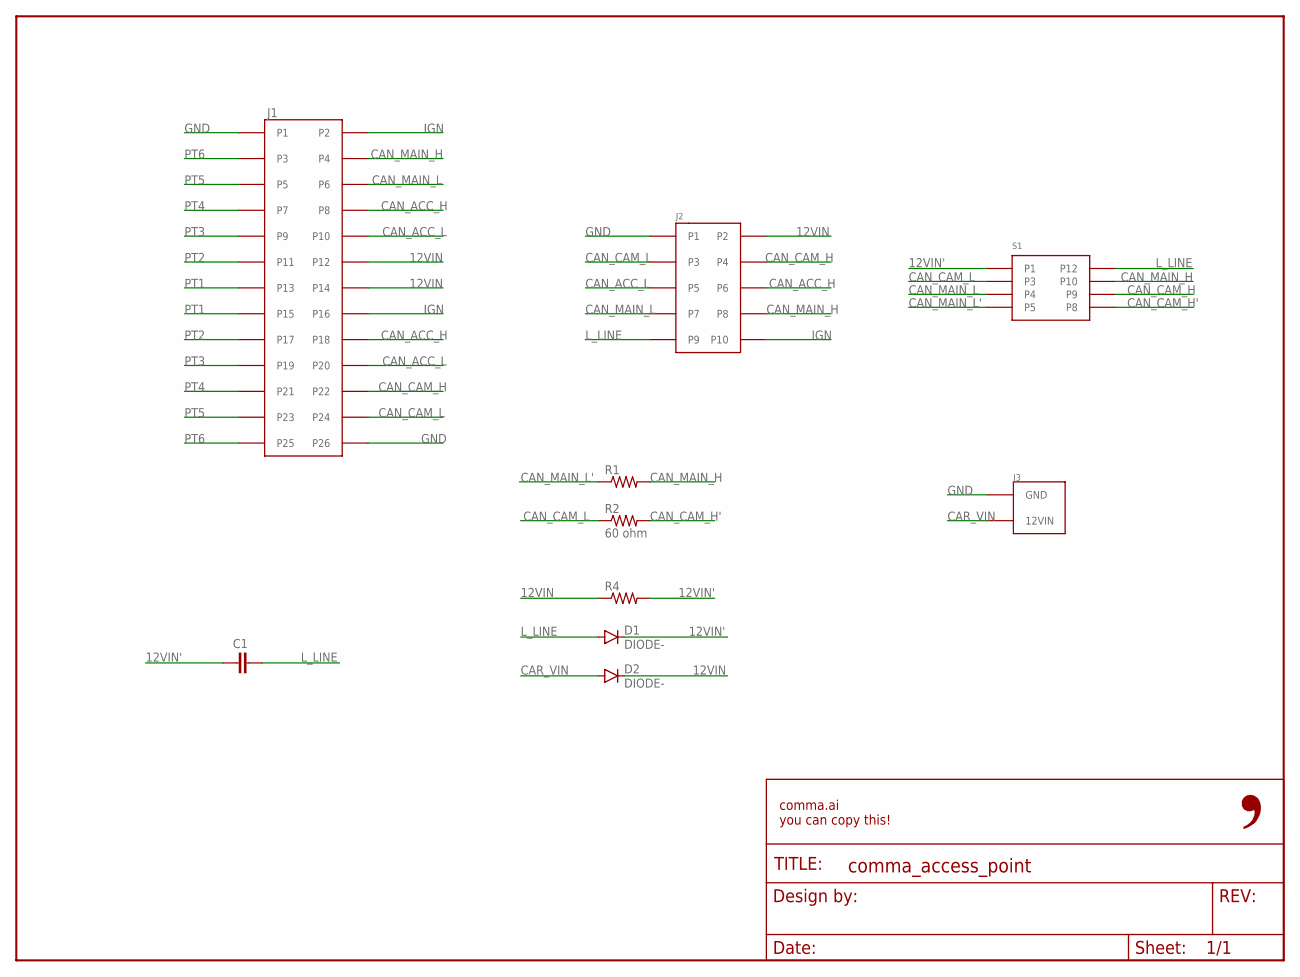
[picture p39: schematic comma_access_point.sch]

Parts:
C1: C0805; 0805-C
D1, D2: DIODE-; DO-214
FRAME1: FRAME-LETTER-OPENNO_PACKAGE; DUMMY
J1: 5018762640
J2: 5018761040
J3: 3-794618-2
R1, R4: R0402; 0402-R
R2: 60 ohm; 0402-R
S1: G6S-2G-DC12; G6S-26-DC12

Connections:
12VIN: D2.1 (C), J1.P12, J1.P14, J2.P2, R4.1
12VIN': C1.1, D1.1 (C), R4.2, S1.P1
CAN_ACC_H: J1.P8, J1.P18, J2.P6
CAN_ACC_L: J1.P10, J1.P20, J2.P5
CAN_CAM_H: J1.P22, J2.P4, S1.P9
CAN_CAM_H': R2.2, S1.P8
CAN_CAM_L: J1.P24, J2.P3, R2.1, S1.P3
CAN_MAIN_H: J1.P4, J2.P8, R1.2, S1.P10
CAN_MAIN_L: J1.P6, J2.P7, S1.P4
CAN_MAIN_L': R1.1, S1.P5
CAR_VIN: D2.2 (A), J3.12VIN
GND: J1.P1, J1.P26, J2.P1, J3.GND
IGN: J1.P2, J1.P16, J2.P10
L_LINE: C1.2, D1.2 (A), J2.P9, S1.P12
PT1: J1.P13, J1.P15
PT2: J1.P11, J1.P17
PT3: J1.P9, J1.P19
PT4: J1.P7, J1.P21
PT5: J1.P5, J1.P23
PT6: J1.P3, J1.P25

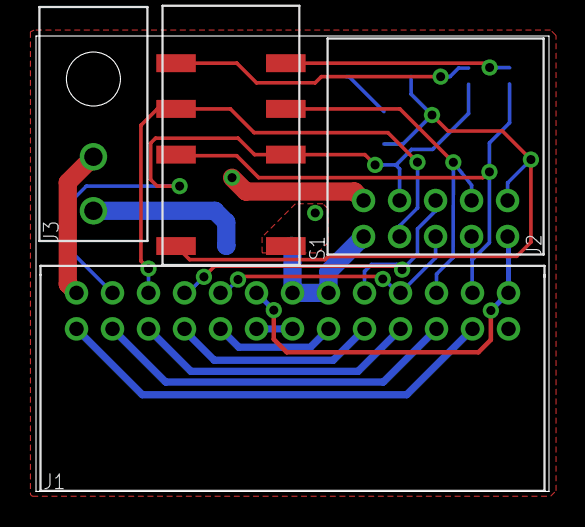
[picture p40: board comma_access_point.brd from above]

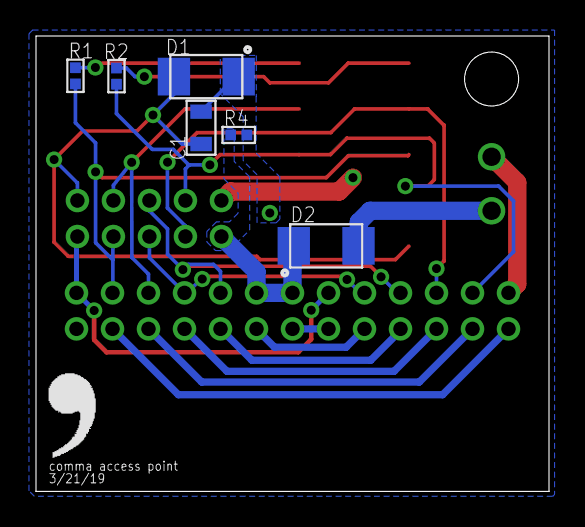
[picture p41: board comma_access_point.brd from below]

Board: 2 copper layers, 28.5 x 25.3 mm, 12 parts (7 on the bottom side), 20 nets.

Other parts of the board:
U$1: LOGO
