xx979xx/neo/giraffe/ford/ford_giraffe.brd

## EAGLE design giraffe/ford/ford_giraffe.brd (2019-06-29)

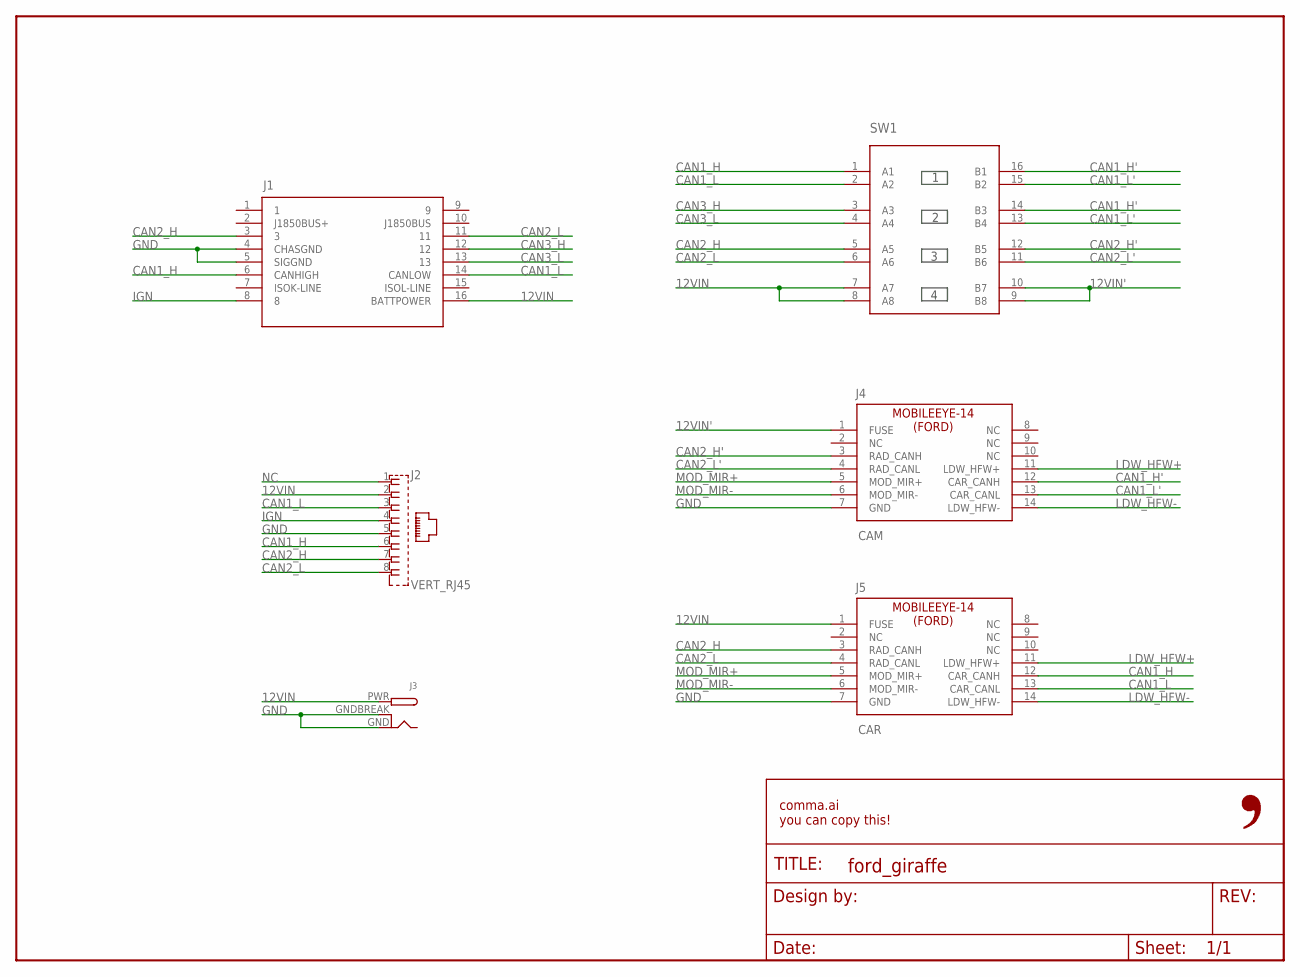
[picture p42: schematic ford_giraffe.sch]

Parts:
FRAME1: FRAME-LETTER-OPENNO_PACKAGE; DUMMY
J1: OBDII-FEMALE-CUT; OBDII-FEMALE-MIDCUT
J2: VERT_RJ45; GLX-S-88M
J3: DCBARRELPTH; DCJACK_2MM_PTH
J4: CAM; 2X7-FORD-CAR
J5: CAR; 2X7-FORD-CAM
SW1: 4XDPSTSMT; 4-DPST

Connections:
12VIN: J1.16 (BATTPOWER), J2.2, J3.PWR, J5.1 (FUSE), SW1.7 (A7), SW1.8 (A8)
12VIN': J4.1 (FUSE), SW1.9 (B8), SW1.10 (B7)
CAN1_H: J1.6 (CANHIGH), J2.6, J5.12 (CAR_CANH), SW1.1 (A1)
CAN1_H': J4.12 (CAR_CANH), SW1.14 (B3), SW1.16 (B1)
CAN1_L: J1.14 (CANLOW), J2.3, J5.13 (CAR_CANL), SW1.2 (A2)
CAN1_L': J4.13 (CAR_CANL), SW1.13 (B4), SW1.15 (B2)
CAN2_H: J1.3, J2.7, J5.3 (RAD_CANH), SW1.5 (A5)
CAN2_H': J4.3 (RAD_CANH), SW1.12 (B5)
CAN2_L: J1.11, J2.8, J5.4 (RAD_CANL), SW1.6 (A6)
CAN2_L': J4.4 (RAD_CANL), SW1.11 (B6)
CAN3_H: J1.12, SW1.3 (A3)
CAN3_L: J1.13, SW1.4 (A4)
GND: J1.4 (CHASGND), J1.5 (SIGGND), J2.5, J3.GND, J3.GNDBREAK, J4.7 (GND), J5.7 (GND)
IGN: J1.8, J2.4
LDW_HFW+: J4.11 (LDW_HFW+), J5.11 (LDW_HFW+)
LDW_HFW-: J4.14 (LDW_HFW-), J5.14 (LDW_HFW-)
MOD_MIR+: J4.5 (MOD_MIR+), J5.5 (MOD_MIR+)
MOD_MIR-: J4.6 (MOD_MIR-), J5.6 (MOD_MIR-)
NC: J2.1

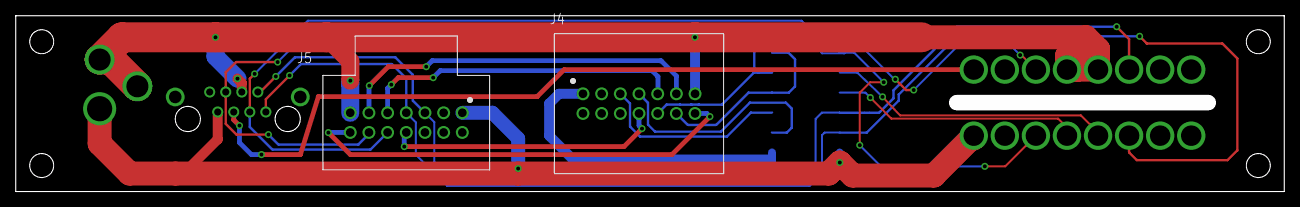
[picture p43: board ford_giraffe.brd from above]

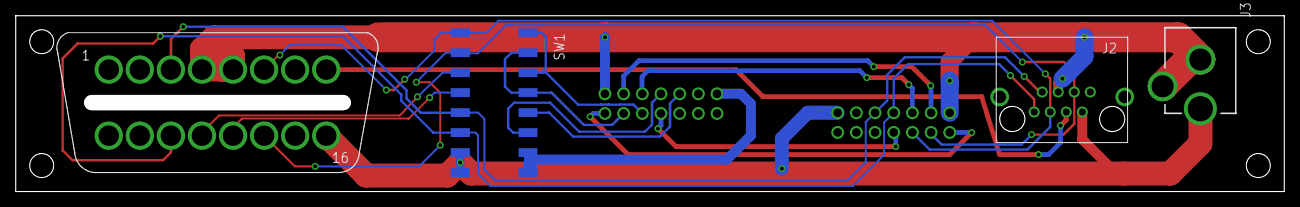
[picture p44: board ford_giraffe.brd from below]

Board: 2 copper layers, 161.3 x 22.4 mm, 7 parts (4 on the bottom side), 18 nets.
