xx979xx/neo/giraffe/hyundai/Hyundai_Giraffe.brd

## EAGLE design giraffe/hyundai/Hyundai_Giraffe.brd (2019-06-29)

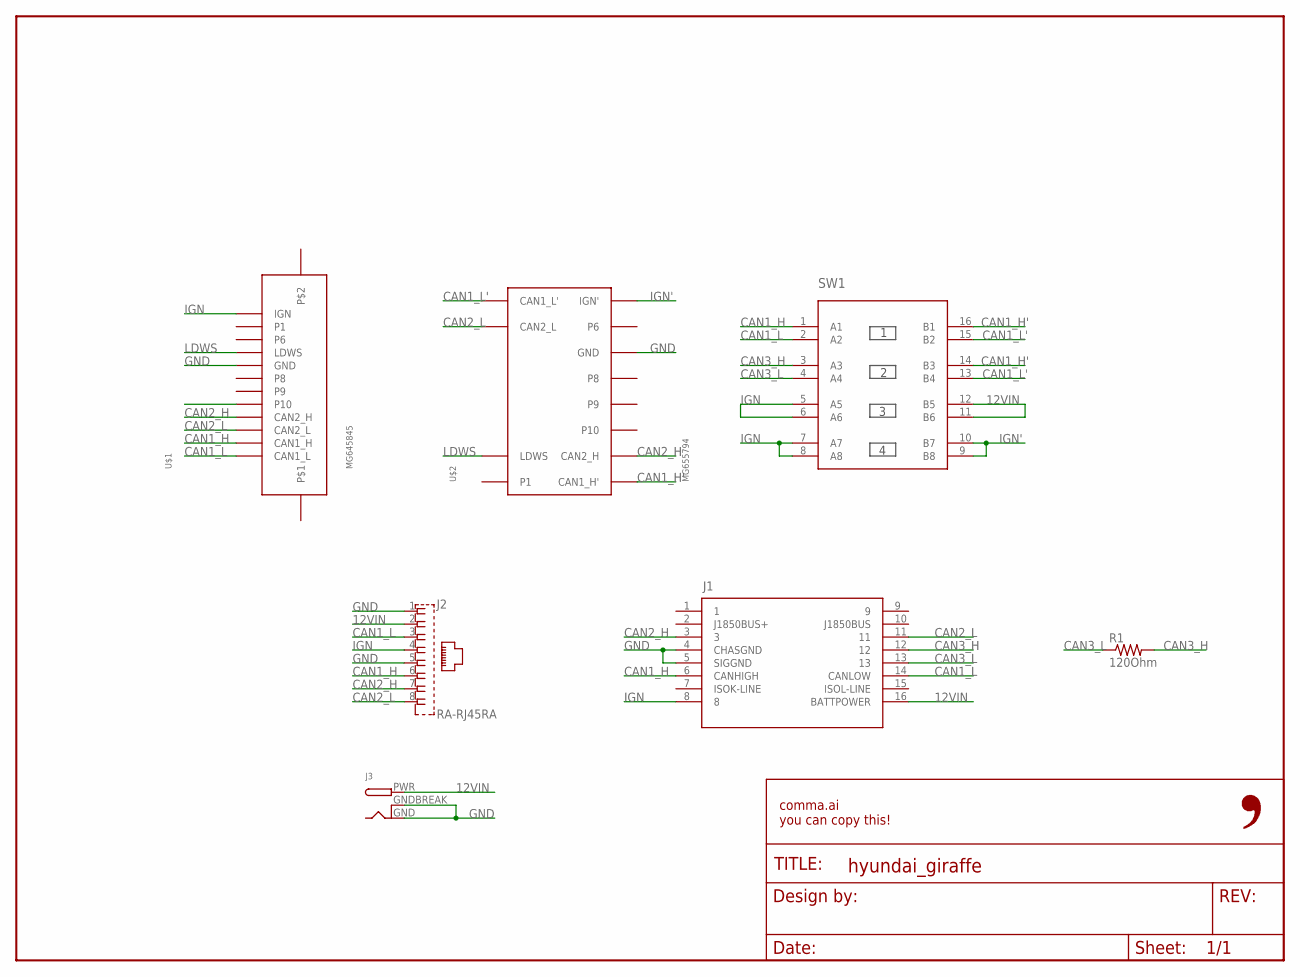
[picture p45: schematic Hyundai_Giraffe.sch]

Parts:
FRAME1: FRAME-LETTER-OPENNO_PACKAGE; DUMMY
J1: OBDII-FEMALE-CUT; OBDII-FEMALE-MIDCUT
J2: RA-RJ45RA; RA-RJ45
J3: DCBARRELPTH; DCJACK_2MM_PTH
R1: 120Ohm; 0603-R
SW1: 4XDPSTSMT; 4-DPST
U$1: MG645845
U$2: MG655794

Connections:
12VIN: J1.16 (BATTPOWER), J2.2, J3.PWR, SW1.11 (B6), SW1.12 (B5)
CAN1_H: J1.6 (CANHIGH), J2.6, SW1.1 (A1), U$1.CAN1_H
CAN1_H': SW1.14 (B3), SW1.16 (B1), U$2.CAN1_H'
CAN1_L: J1.14 (CANLOW), J2.3, SW1.2 (A2), U$1.CAN1_L
CAN1_L': SW1.13 (B4), SW1.15 (B2), U$2.CAN1_L'
CAN2_H: J1.3, J2.7, U$1.CAN2_H, U$2.CAN2_H
CAN2_L: J1.11, J2.8, U$1.CAN2_L, U$2.CAN2_L
CAN3_H: J1.12, R1.2, SW1.3 (A3)
CAN3_L: J1.13, R1.1, SW1.4 (A4)
GND: J1.4 (CHASGND), J1.5 (SIGGND), J2.1, J2.5, J3.GND, J3.GNDBREAK, U$1.GND, U$2.GND
IGN: J1.8, J2.4, SW1.5 (A5), SW1.6 (A6), SW1.7 (A7), SW1.8 (A8), U$1.IGN
IGN': SW1.9 (B8), SW1.10 (B7), U$2.IGN'
LDWS: U$1.LDWS, U$2.LDWS

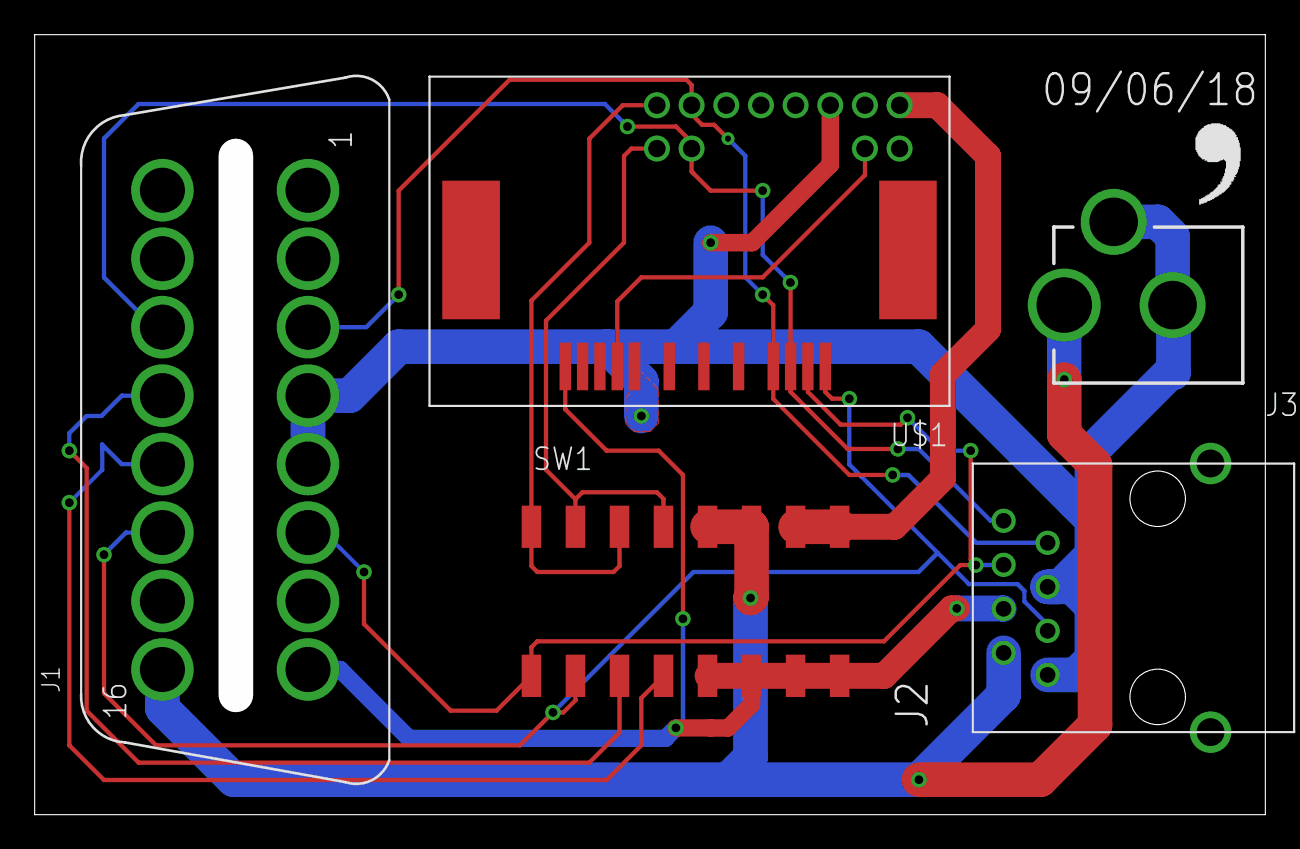
[picture p46: board Hyundai_Giraffe.brd from above]

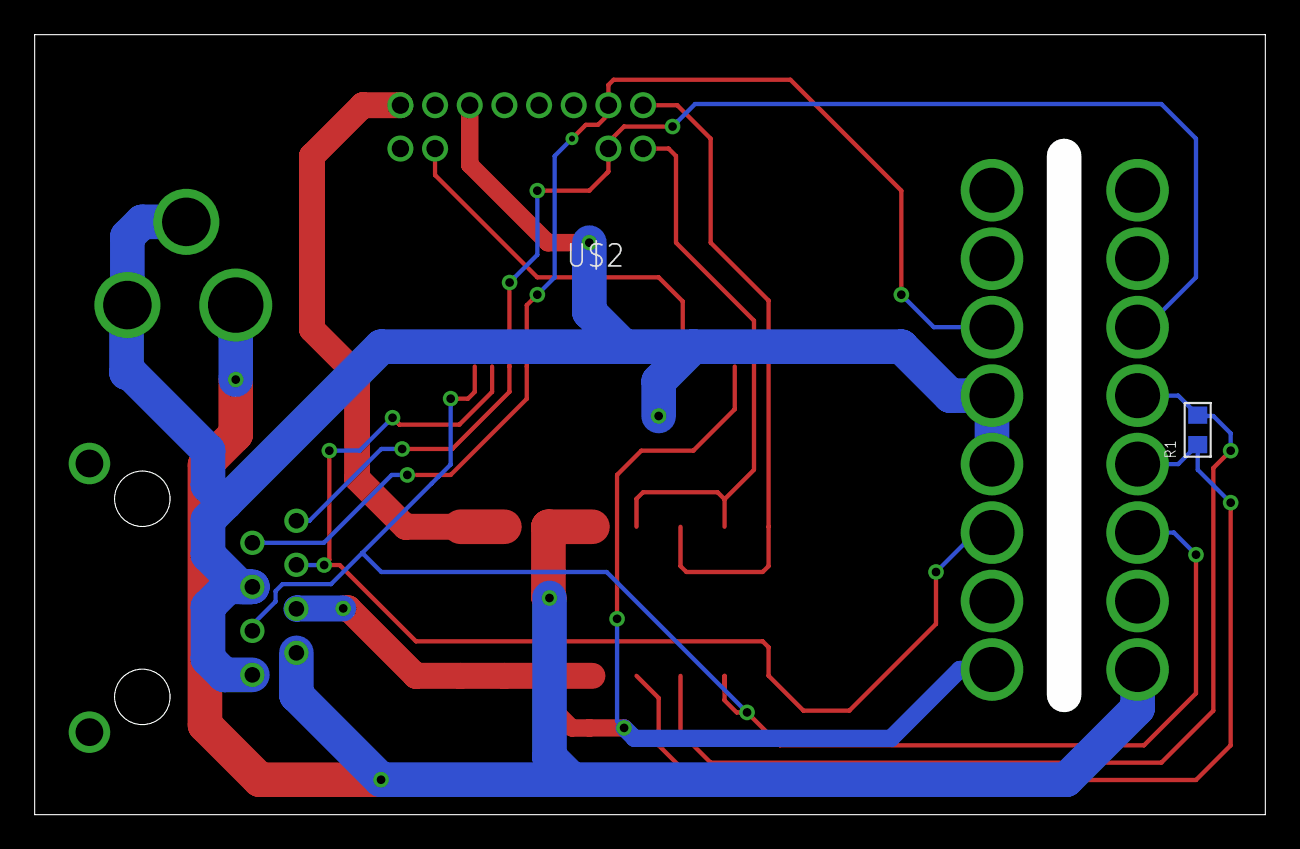
[picture p47: board Hyundai_Giraffe.brd from below]

Board: 2 copper layers, 71.0 x 45.0 mm, 9 parts (2 on the bottom side), 13 nets.

Other parts of the board:
U$3: LOGO
