xx979xx/neo/giraffe/subaru/panda_interface_point.brd

## EAGLE design giraffe/subaru/panda_interface_point.brd (2019-06-29)

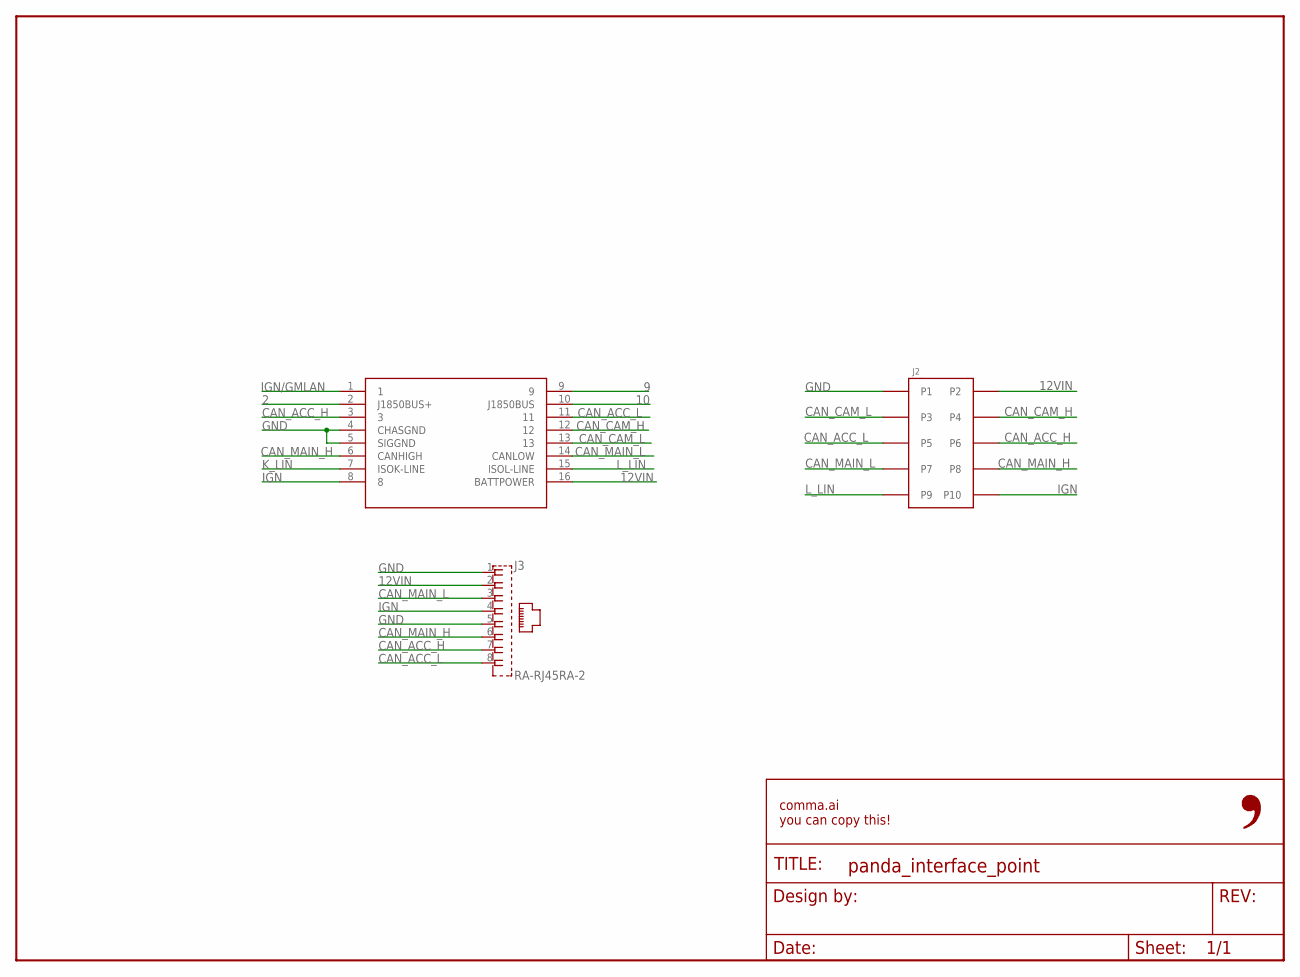
[picture p48: schematic panda_interface_point.sch]

Parts:
FRAME1: FRAME-LETTER-OPENNO_PACKAGE; DUMMY
J1: OBDII-FEMALE-CUT; OBDII-FEMALE-MIDCUT
J2: 5018761040
J3: RA-RJ45RA-2; RA-RJ45-2

Connections:
2: J1.2 (J1850BUS+)
9: J1.9
10: J1.10 (J1850BUS)
12VIN: J1.16 (BATTPOWER), J2.P2, J3.2
CAN_ACC_H: J1.3, J2.P6, J3.7
CAN_ACC_L: J1.11, J2.P5, J3.8
CAN_CAM_H: J1.12, J2.P4
CAN_CAM_L: J1.13, J2.P3
CAN_MAIN_H: J1.6 (CANHIGH), J2.P8, J3.6
CAN_MAIN_L: J1.14 (CANLOW), J2.P7, J3.3
GND: J1.4 (CHASGND), J1.5 (SIGGND), J2.P1, J3.1, J3.5
IGN: J1.8, J2.P10, J3.4
IGN/GMLAN: J1.1
K_LIN: J1.7 (ISOK-LINE)
L_LIN: J1.15 (ISOL-LINE), J2.P9

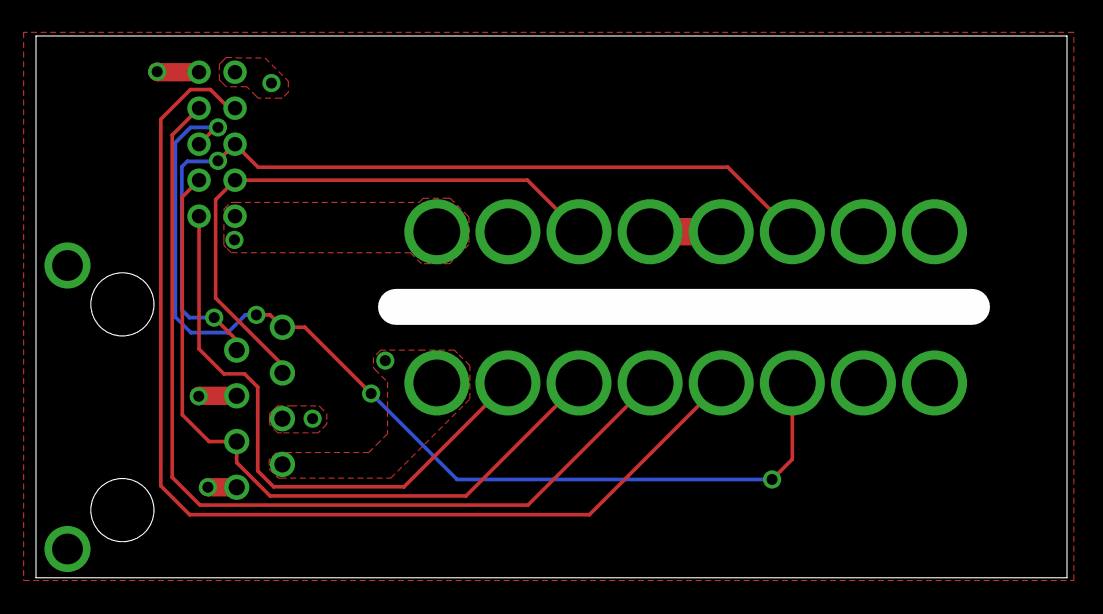
[picture p49: board panda_interface_point.brd from above]

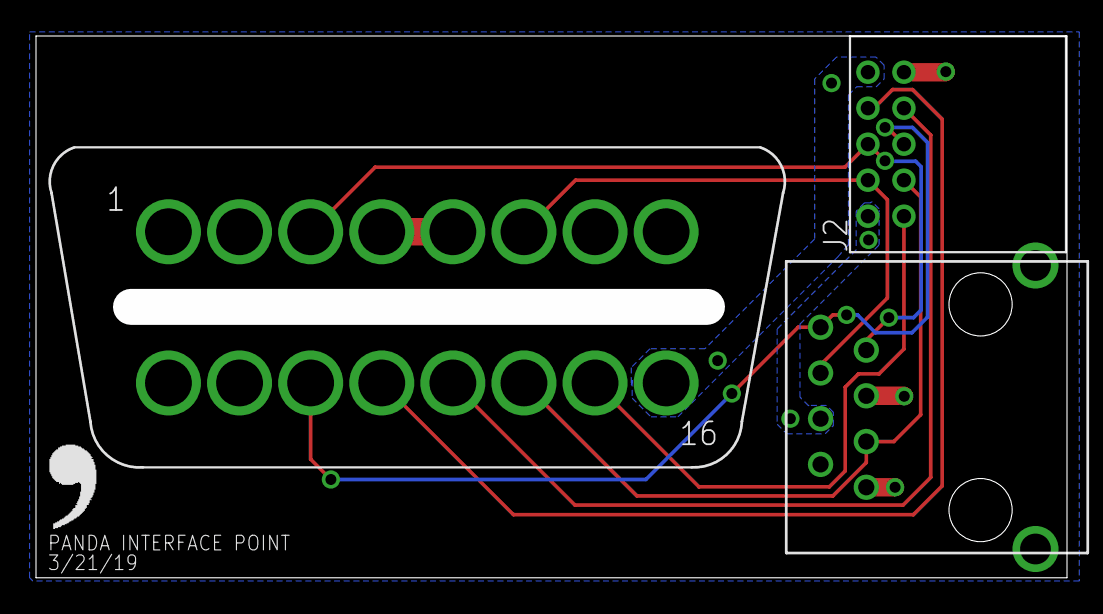
[picture p50: board panda_interface_point.brd from below]

Board: 2 copper layers, 57.3 x 30.1 mm, 5 parts (4 on the bottom side), 10 nets.

Other parts of the board:
U$1: LOGO
