xx979xx/neo/interface boards/gm/giraffe.brd

## EAGLE design interface boards/gm/giraffe.brd (2019-06-29)

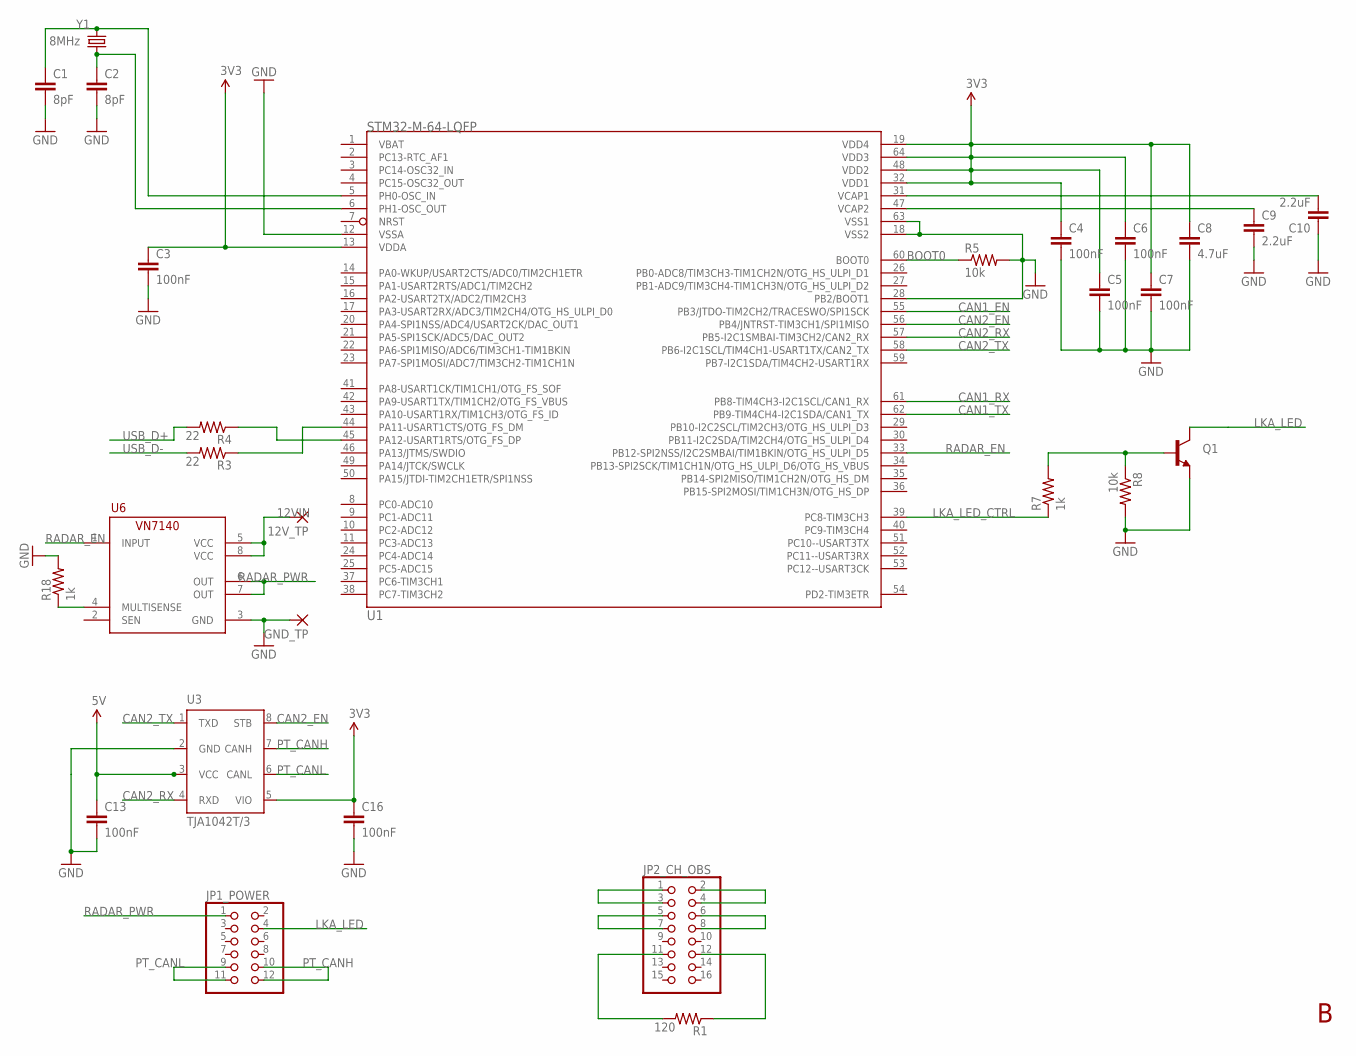
[picture p51: schematic giraffe.sch, sheet 1]

Parts:
12V_TP: 2,15/1,0
C1, C2: 8pF; 0603-CAP
C3, C4, C5, C6, C7, C13, C16: 100nF; 0603-CAP
C8: 4.7uF; 0603-CAP
C9, C10: 2.2uF; 0603-CAP
GND_TP: 2,15/1,0
JP1_POWER: PINHD-2X6; 2X06
JP2_CH_OBS: PINHD-2X8; 2X08
Q1: MMBT2222A; SOT23-3
R1: 120; R0603
R3, R4: 22; R0603
R5, R8: 10k; R0603
R7, R18: 1k; R0603
U1: STM32-M-64-LQFP; LQFP64
U3: TJA1042T/3; SO-8-L
U6: VN7140; SO08
Y1: 8MHz; CRYSTAL-TXC-7A

Connections:
3V3: C3.1, C4.1, C5.1, C6.1, C7.1, C8.1, C16.1, U1.13 (VDDA), U1.19 (VDD4), U1.32 (VDD1), U1.48 (VDD2), U1.64 (VDD3), U3.5 (VIO); also elsewhere on the board
5V: C13.1, U3.3 (VCC); also elsewhere on the board
12VIN: 12V_TP.1, U6.5 (VCC), U6.8 (VCC); also elsewhere on the board
BOOT0: R5.1, U1.60 (BOOT0)
CAN1_EN: U1.55 (PB3/JTDO-TIM2CH2/TRACESWO/SPI1SCK)
CAN1_RX: U1.61 (PB8-TIM4CH3-I2C1SCL/CAN1_RX)
CAN1_TX: U1.62 (PB9-TIM4CH4-I2C1SDA/CAN1_TX)
CAN2_EN: U1.56 (PB4/JNTRST-TIM3CH1/SPI1MISO), U3.8 (STB)
CAN2_RX: U1.57 (PB5-I2C1SMBAI-TIM3CH2/CAN2_RX), U3.4 (RXD)
CAN2_TX: U1.58 (PB6-I2C1SCL/TIM4CH1-USART1TX/CAN2_TX), U3.1 (TXD)
GND: C1.2, C2.2, C3.2, C4.2, C5.2, C6.2, C7.2, C8.2, C9.2, C10.1, C13.2, C16.2, GND_TP.1, Q1.2 (E), R5.2, R8.2, R18.2, U1.12 (VSSA), U1.18 (VSS2), U1.28 (PB2/BOOT1), U1.63 (VSS1), U3.2 (GND), U6.3 (GND); also elsewhere on the board
LKA_LED: JP1_POWER.4, Q1.3 (C)
LKA_LED_CTRL: R7.1, U1.39 (PC8-TIM3CH3)
unnamed: C1.1, U1.5 (PH0-OSC_IN), Y1.P$1 (1)
unnamed: JP2_CH_OBS.2, JP2_CH_OBS.4
unnamed: C2.1, U1.6 (PH1-OSC_OUT), Y1.P$2 (2)
unnamed: R4.1, U1.45 (PA12-USART1RTS/OTG_FS_DP)
unnamed: JP2_CH_OBS.1, JP2_CH_OBS.3
unnamed: Q1.1 (B), R7.2, R8.1
unnamed: JP2_CH_OBS.6, JP2_CH_OBS.8
unnamed: JP2_CH_OBS.5, JP2_CH_OBS.7
unnamed: R18.1, U6.4 (MULTISENSE)
unnamed: JP2_CH_OBS.11, R1.2
unnamed: JP2_CH_OBS.12, R1.1
unnamed: R3.1, U1.44 (PA11-USART1CTS/OTG_FS_DM)
PT_CANH: JP1_POWER.10, JP1_POWER.12, U3.7 (CANH)
PT_CANL: JP1_POWER.9, JP1_POWER.11, U3.6 (CANL)
RADAR_EN: U1.33 (PB12-SPI2NSS/I2C2SMBAI/TIM1BKIN/OTG_HS_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), U6.1 (INPUT)
RADAR_PWR: JP1_POWER.1, U6.6 (OUT), U6.7 (OUT)
USB_D+: R4.2
USB_D-: R3.2
VCAP1: C10.2, U1.31 (VCAP1)
VCAP2: C9.1, U1.47 (VCAP2)

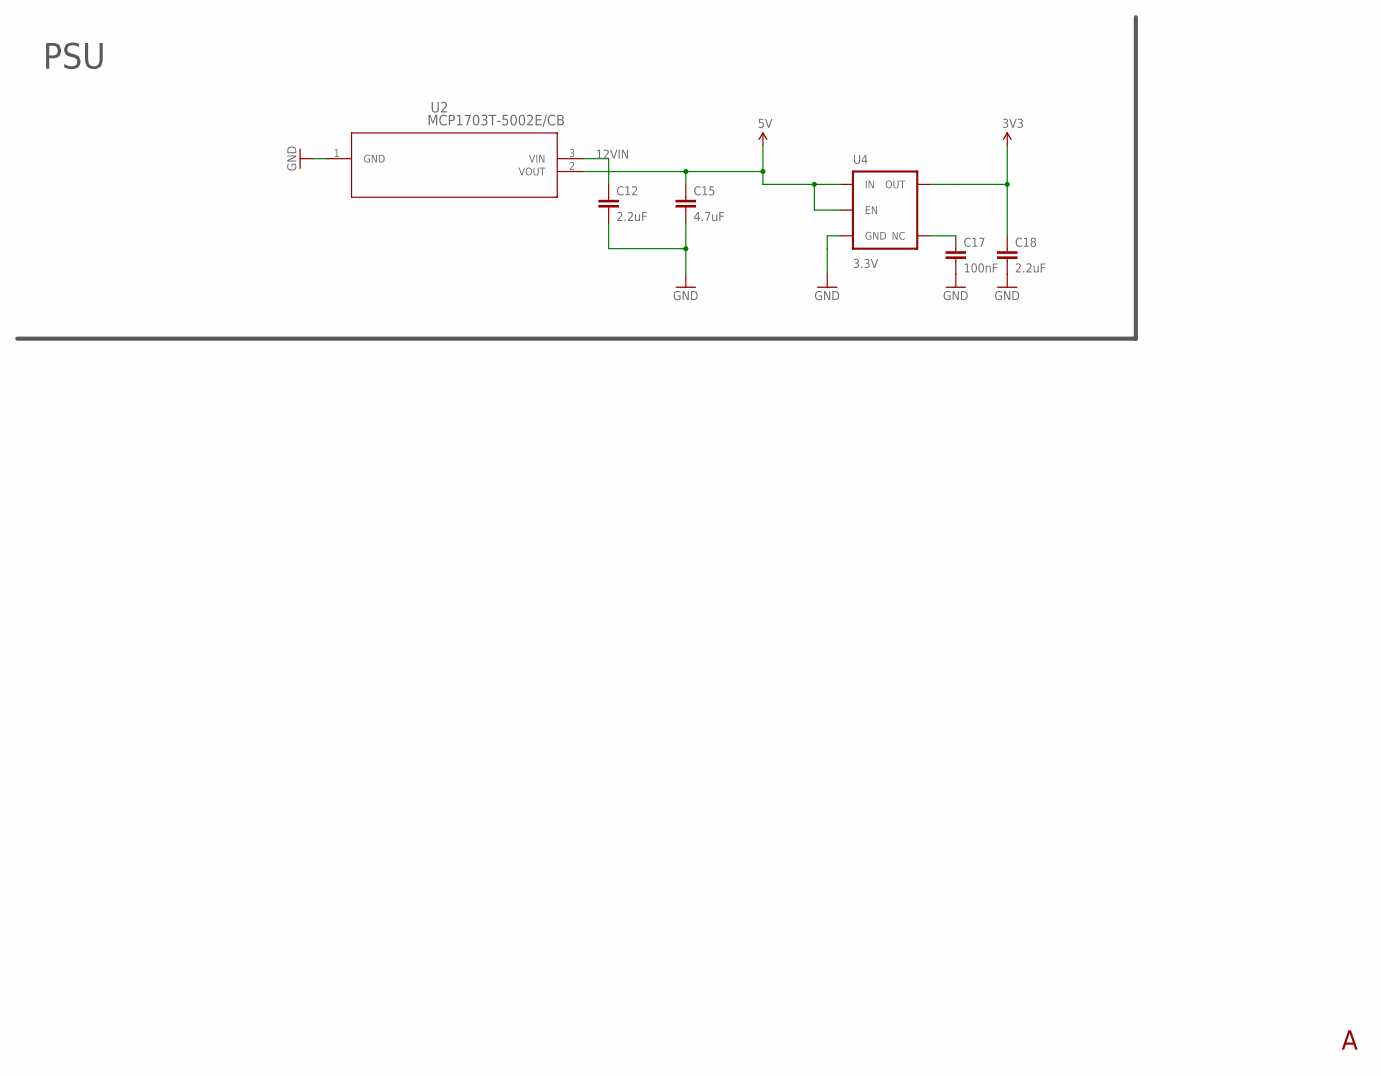
[picture p52: schematic giraffe.sch, sheet 2]

Parts:
C12: 2.2uF; 0805-CAP
C15: 4.7uF; 0603-CAP
C17: 100nF; 0603-CAP
C18: 2.2uF; 0603-CAP
U2: MCP1703T-5002E/CB; SOT-23A_MC
U4: 3.3V; SOT23-5

Connections:
3V3: C18.1, U4.5 (OUT); also elsewhere on the board
5V: C15.1, U2.2 (VOUT), U4.1 (IN), U4.3 (EN); also elsewhere on the board
12VIN: C12.1, U2.3 (VIN); also elsewhere on the board
GND: C12.2, C15.2, C17.2, C18.2, U2.1 (GND), U4.2 (GND); also elsewhere on the board
unnamed: C17.1, U4.4 (NC)

Notes on the sheet:
PSU

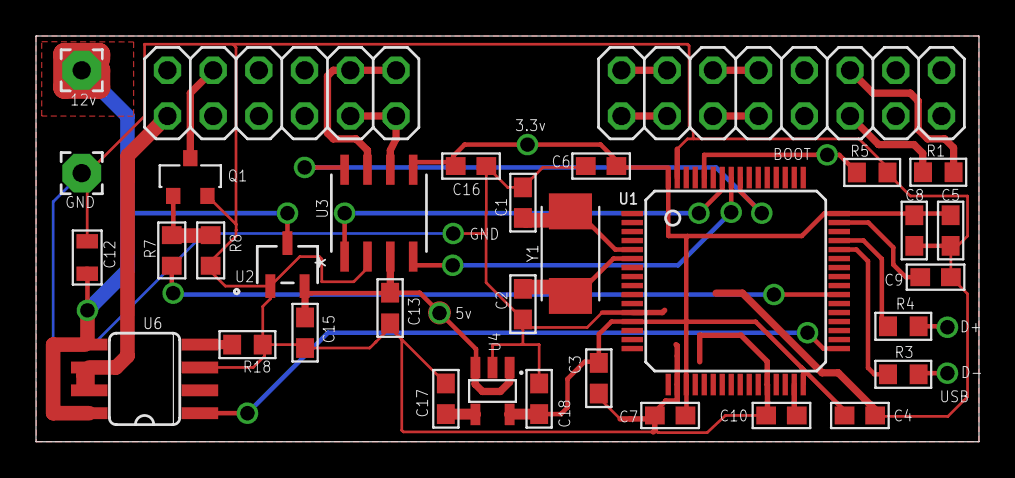
[picture p53: board giraffe.brd from above]

Board: 2 copper layers, 52.4 x 22.5 mm, 34 parts (0 on the bottom side), 29 nets.
